Joshluk3328j/FYP/agatha/readme

this file has the ultrasonics implemented but they still dont identify obstacles when the robot is in motion and at certain angles.

the imu and odom are utilised here and fused together
