Joshluk3328j/FYP/Final Year Project_bb.png

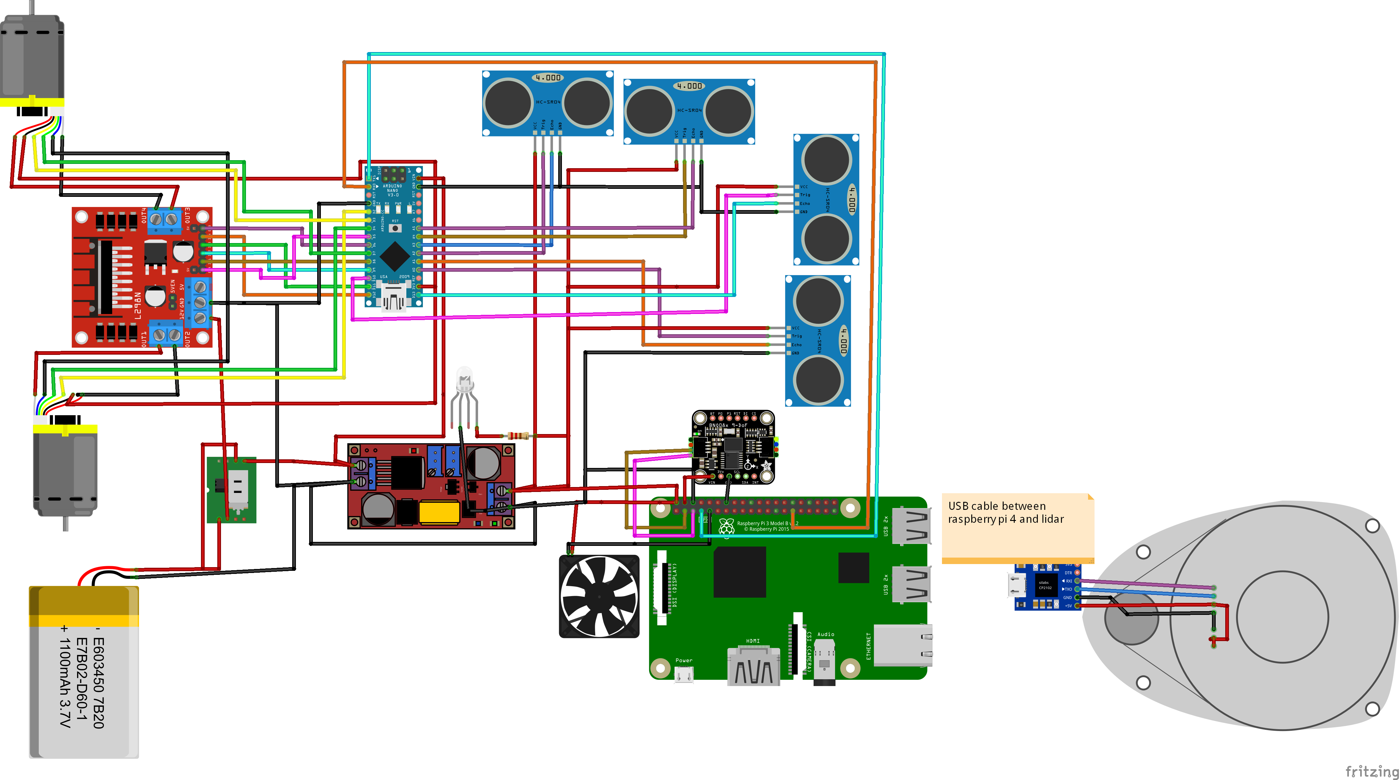
Final Year Project_bb.png
