Joshluk3328j/FYP/Final Year Project_schem.png

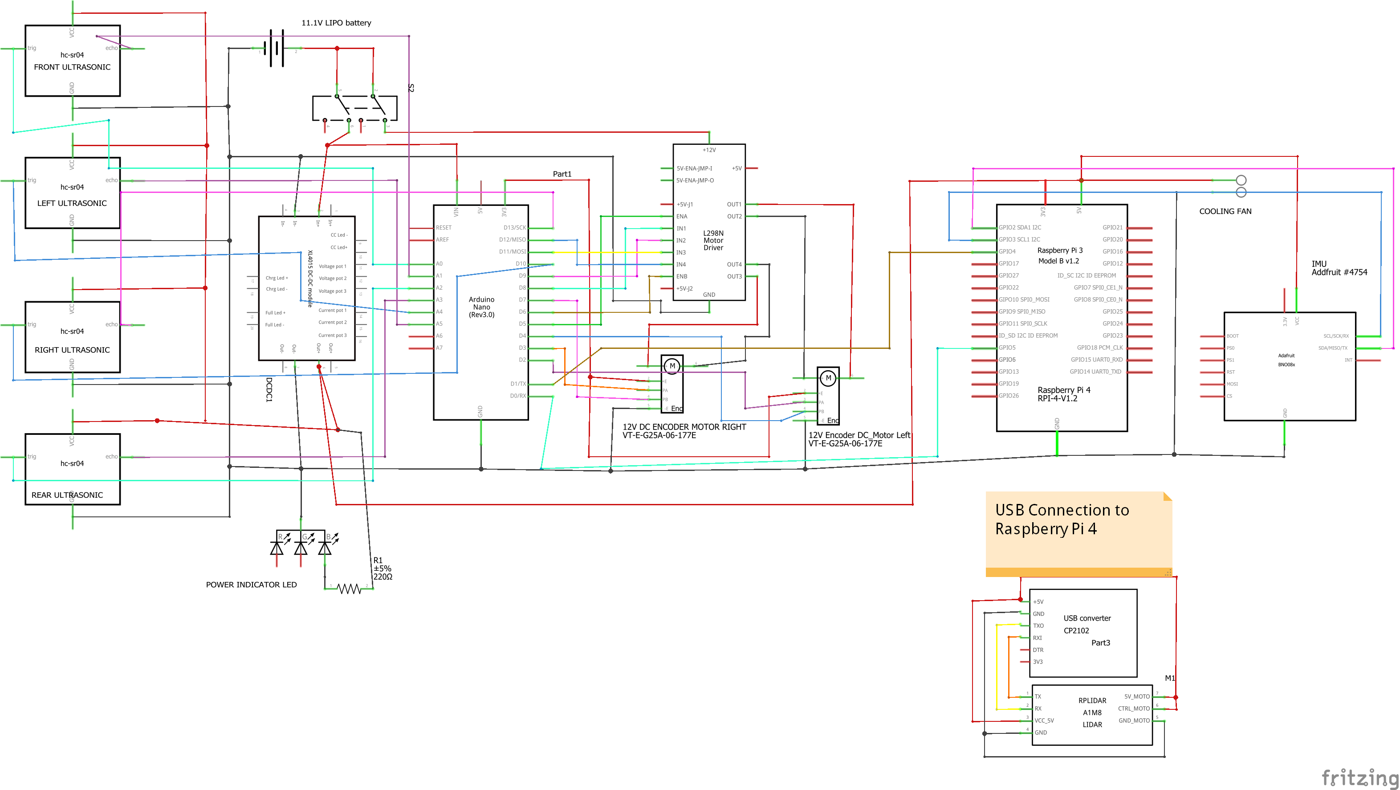
Final Year Project_schem.png
