Joshluk3328j/FYP/Screenshot from 2026-04-25 02-01-53.png

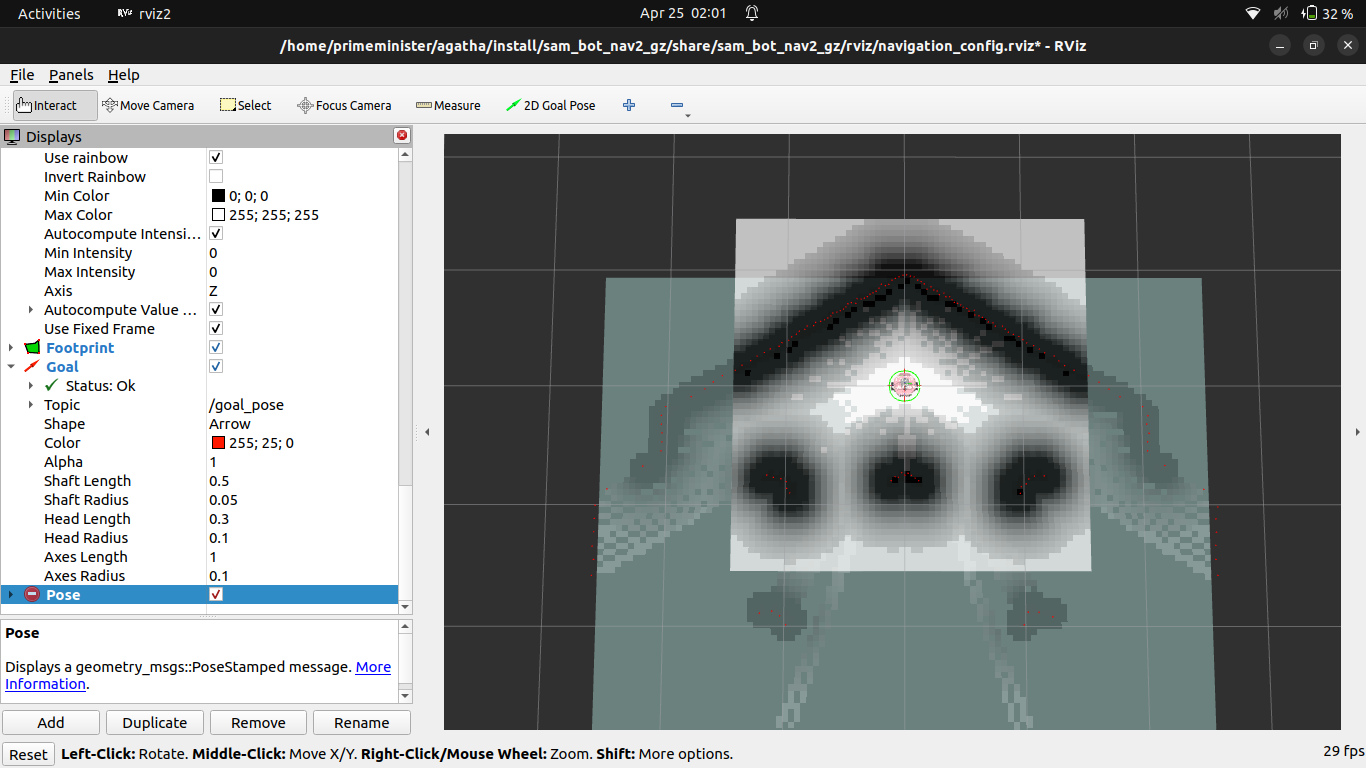
Screenshot from 2026-04-25 02-01-53.png
