Joshluk3328j/FYP/Screenshot from 2026-04-25 02-02-07.png

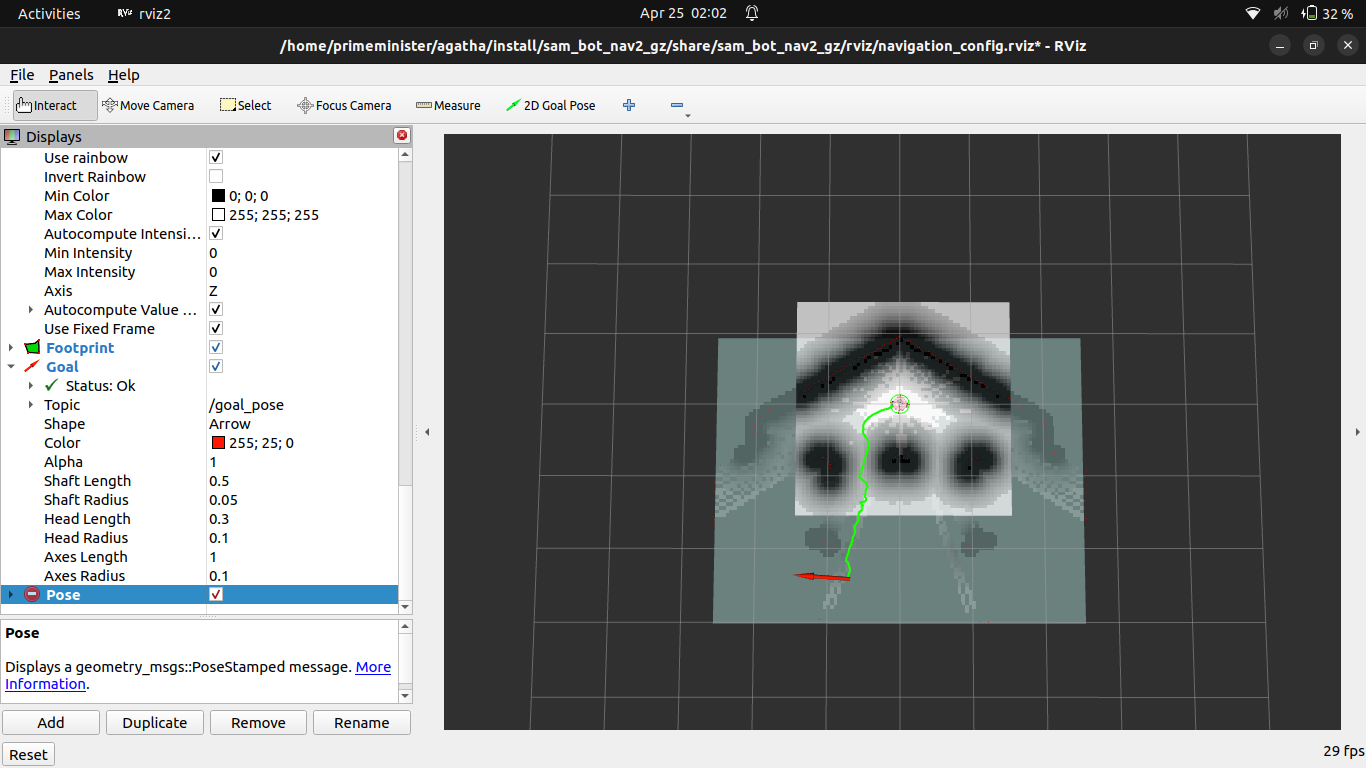
Screenshot from 2026-04-25 02-02-07.png
