Joshluk3328j/FYP/Turtle_world.png

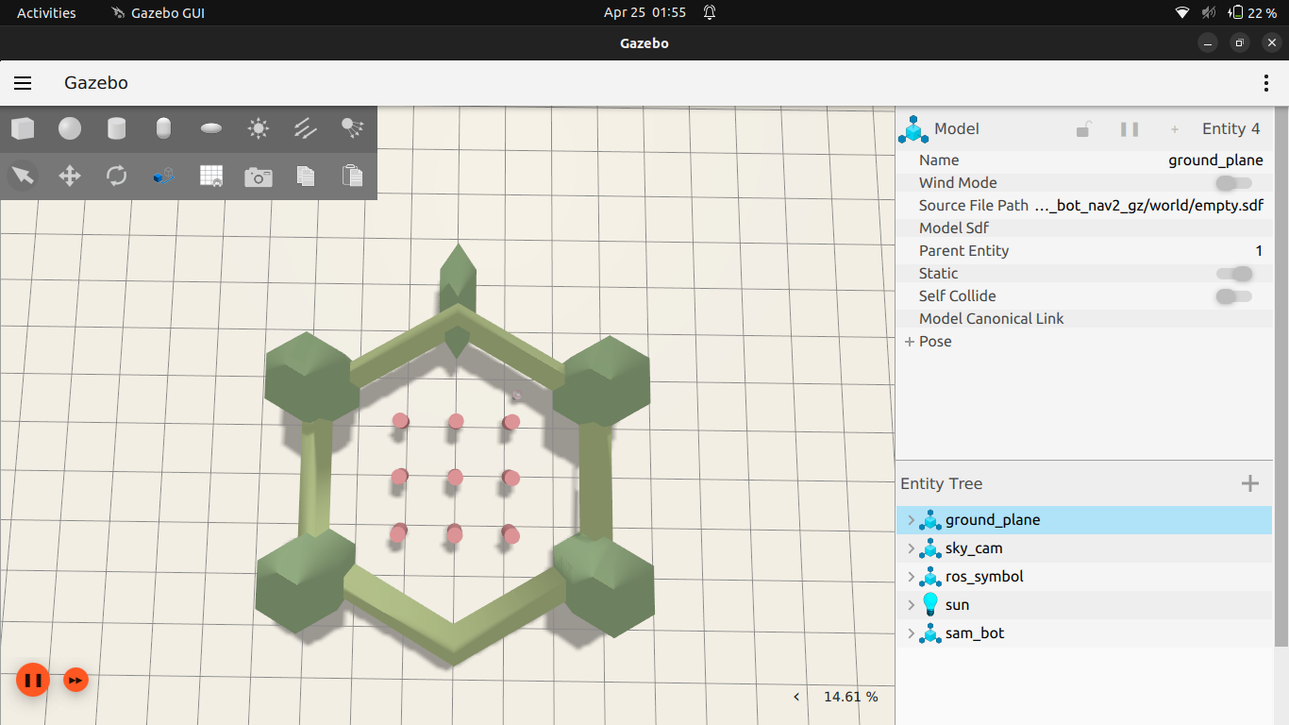
Turtle_world.png
