Joshluk3328j/FYP/AGATHA_CAD_Model/parts/Caster-swivel-40mm_assembly.step

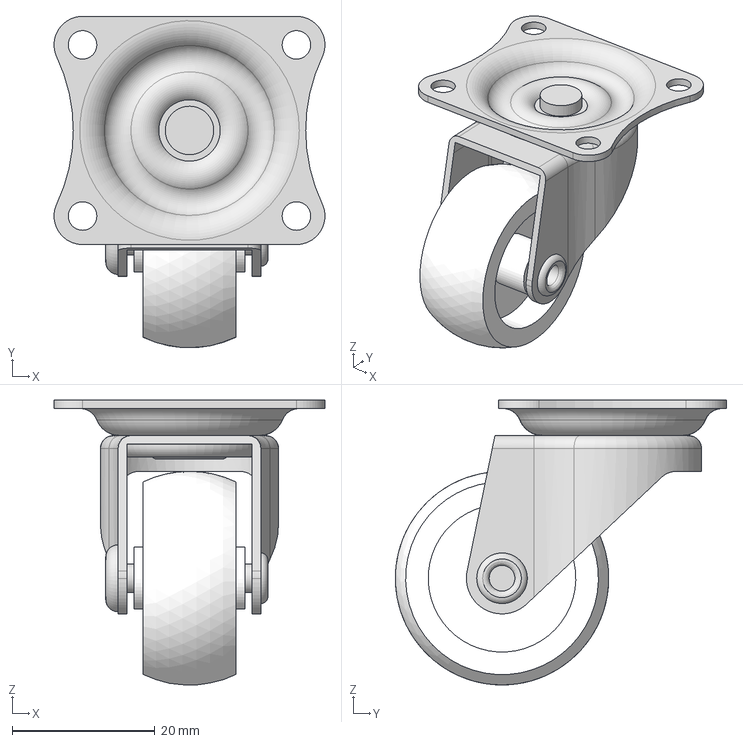
[picture p8: CAD file, 2026-02-10]
AGATHA_CAD_Model/parts/Caster-swivel-40mm_assembly.step
38.0 x 46.5 x 40.0 mm
