Joshluk3328j/FYP/agatha/install/sam_bot_nav2_gz/share/sam_bot_nav2_gz/meshes/front_ultrasonic.STL

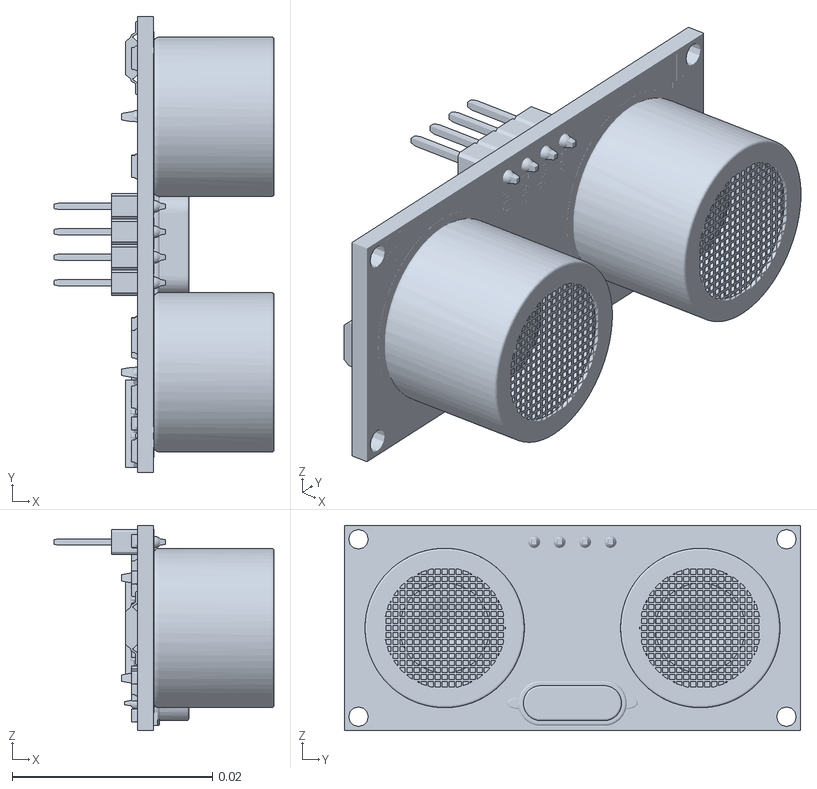
[picture p9: CAD file, 2026-10-19]
agatha/install/sam_bot_nav2_gz/share/sam_bot_nav2_gz/meshes/front_ultrasonic.STL
0.0219 x 0.0455 x 0.0205
