Joshluk3328j/FYP/AGATHA_CAD_Model/Assem2/meshes/right_wheel.STL

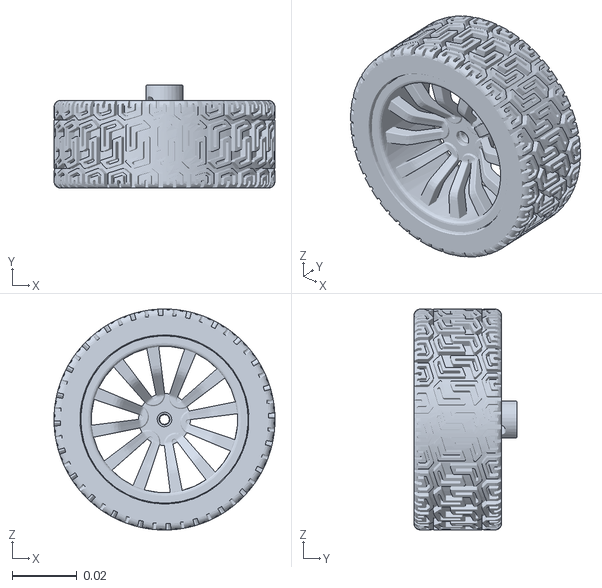
[picture p10: CAD file, 2026-02-10]
AGATHA_CAD_Model/Assem2/meshes/right_wheel.STL
0.068 x 0.0317 x 0.068
