Joshluk3328j/FYP/agatha/install/sam_bot_nav2_gz/share/sam_bot_nav2_gz/meshes/lidar.STL

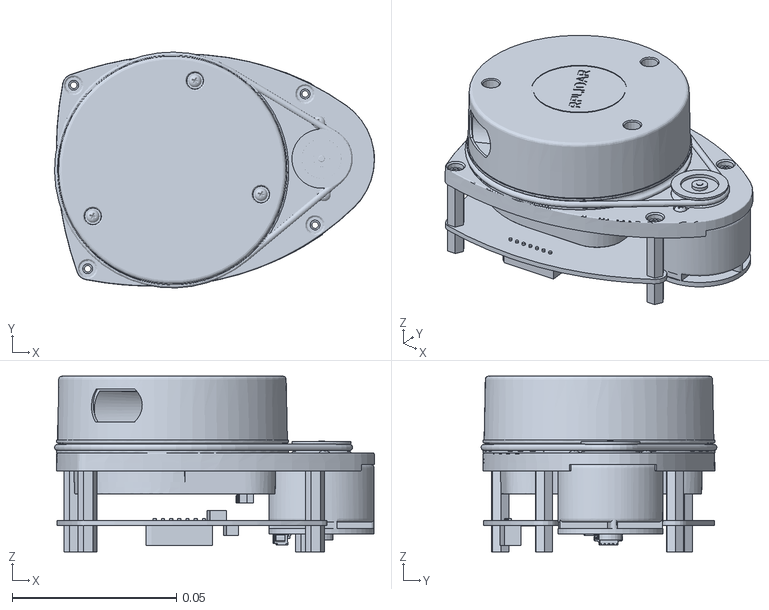
[picture p11: CAD file, 2026-10-19]
agatha/install/sam_bot_nav2_gz/share/sam_bot_nav2_gz/meshes/lidar.STL
0.0974 x 0.0718 x 0.0535
