Joshluk3328j/FYP/agatha/meshes/front_castor_wheel.STL

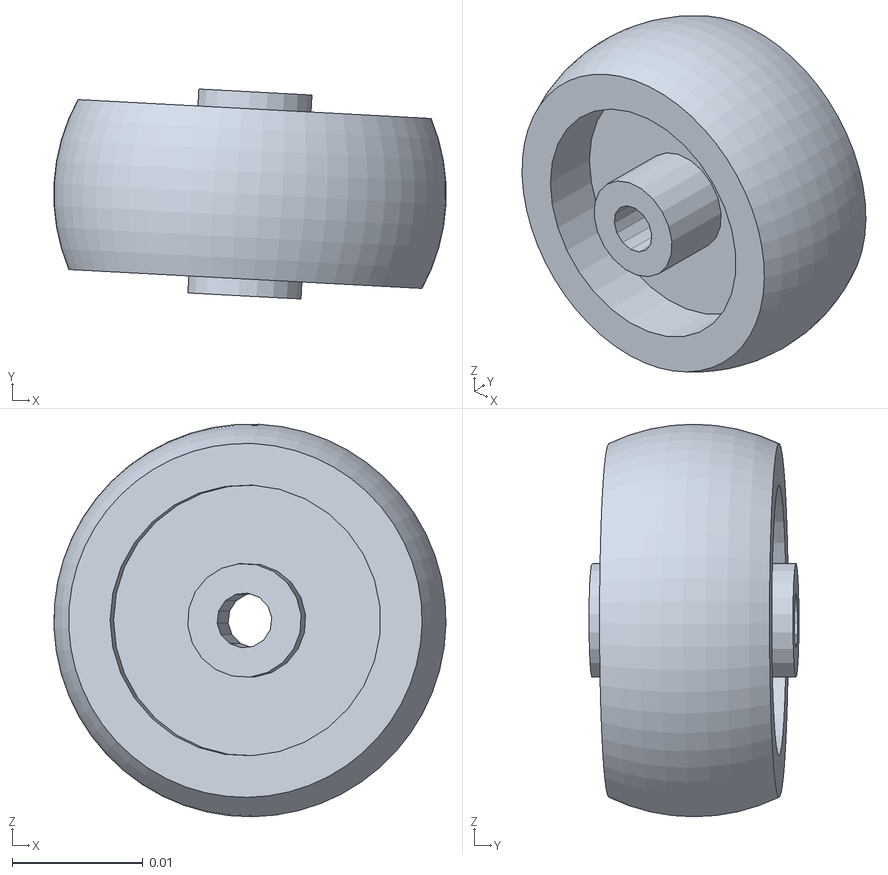
[picture p12: CAD file, 2026-02-10]
agatha/meshes/front_castor_wheel.STL
0.0299 x 0.016 x 0.03
