Joshluk3328j/FYP/AGATHA_CAD_Model/Assem2/meshes/front_castor_swivel.STL

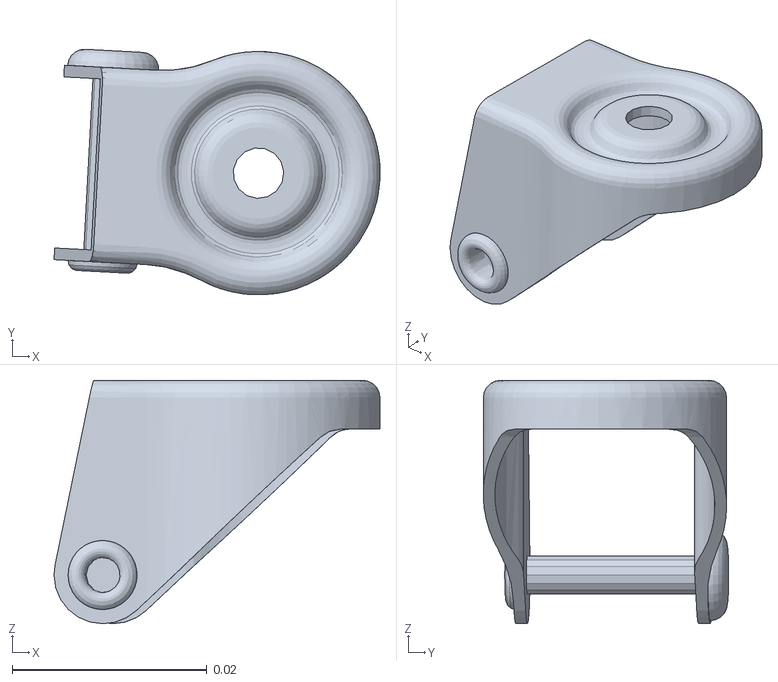
[picture p13: CAD file, 2026-02-10]
AGATHA_CAD_Model/Assem2/meshes/front_castor_swivel.STL
0.0335 x 0.0252 x 0.025
