Joshluk3328j/FYP/agatha/src/meshes/tof.STL

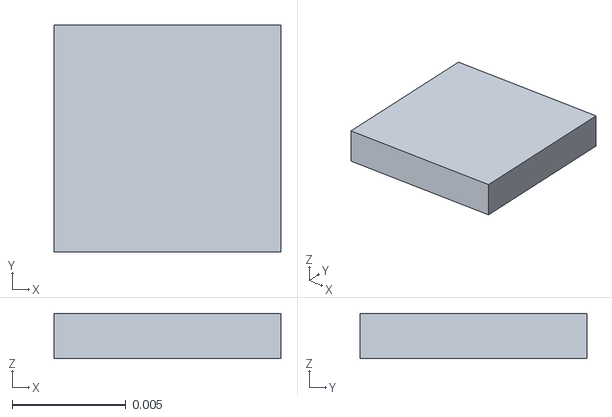
[picture p14: CAD file, 2026-02-10]
agatha/src/meshes/tof.STL
0.01 x 0.01 x 0.002
