Joshluk3328j/FYP/agatha/install/sam_bot_nav2_gz/share/sam_bot_nav2_gz/meshes/base_link.STL

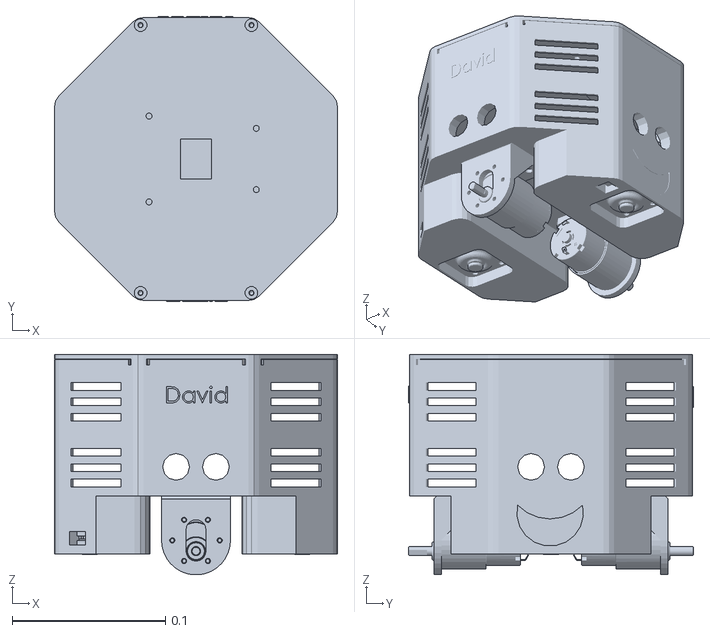
[picture p15: CAD file, 2026-02-10]
agatha/install/sam_bot_nav2_gz/share/sam_bot_nav2_gz/meshes/base_link.STL
0.185 x 0.186 x 0.144
