Joshluk3328j/FYP/agatha/src/meshes/imu.STL

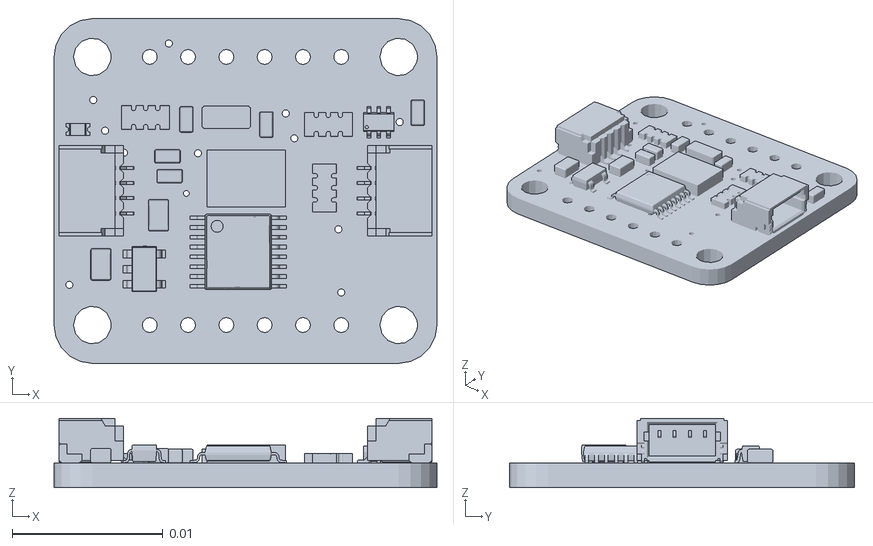
[picture p16: CAD file, 2026-02-10]
agatha/src/meshes/imu.STL
0.0254 x 0.0229 x 0.0046
