Joshluk3328j/FYP/agatha/src/meshes/rear_castor_swivel.STL

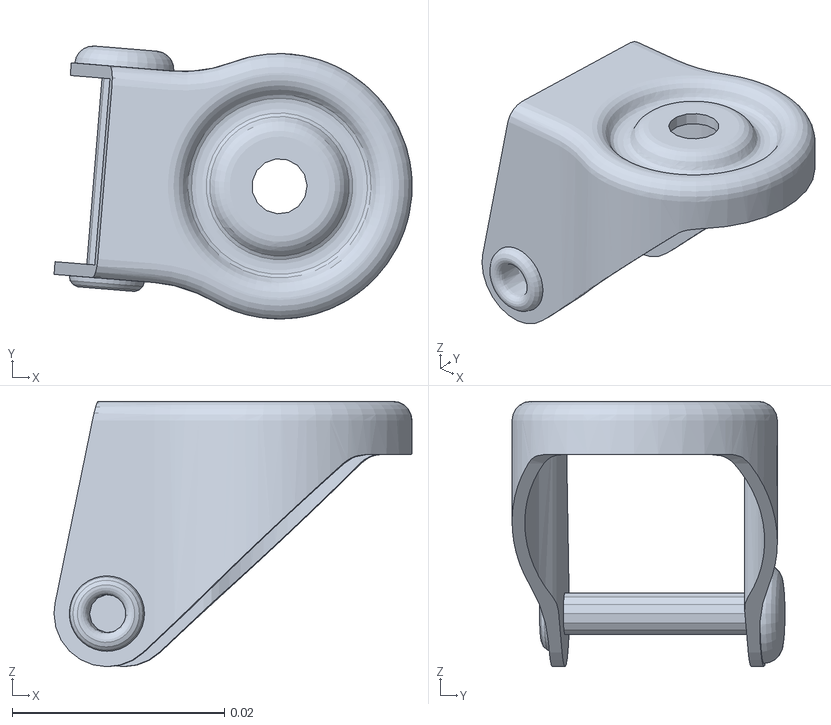
[picture p17: CAD file, 2026-02-10]
agatha/src/meshes/rear_castor_swivel.STL
0.0337 x 0.0257 x 0.025
