Joshluk3328j/FYP/AGATHA_CAD_Model/parts/Base.SLDPRT

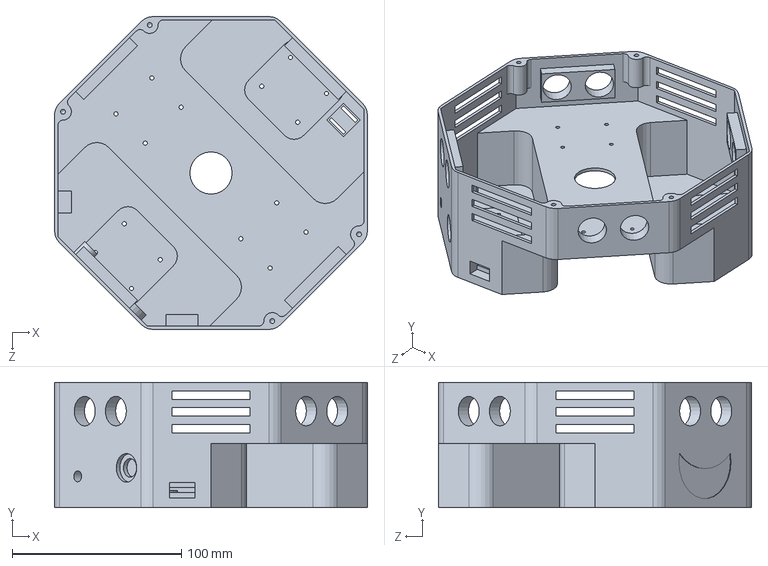
[picture p18: CAD file, 2026-04-25]
AGATHA_CAD_Model/parts/Base.SLDPRT
184.8 x 74.0 x 184.8 mm
