Joshluk3328j/FYP/AGATHA_CAD_Model/parts/Body1_caster.SLDPRT

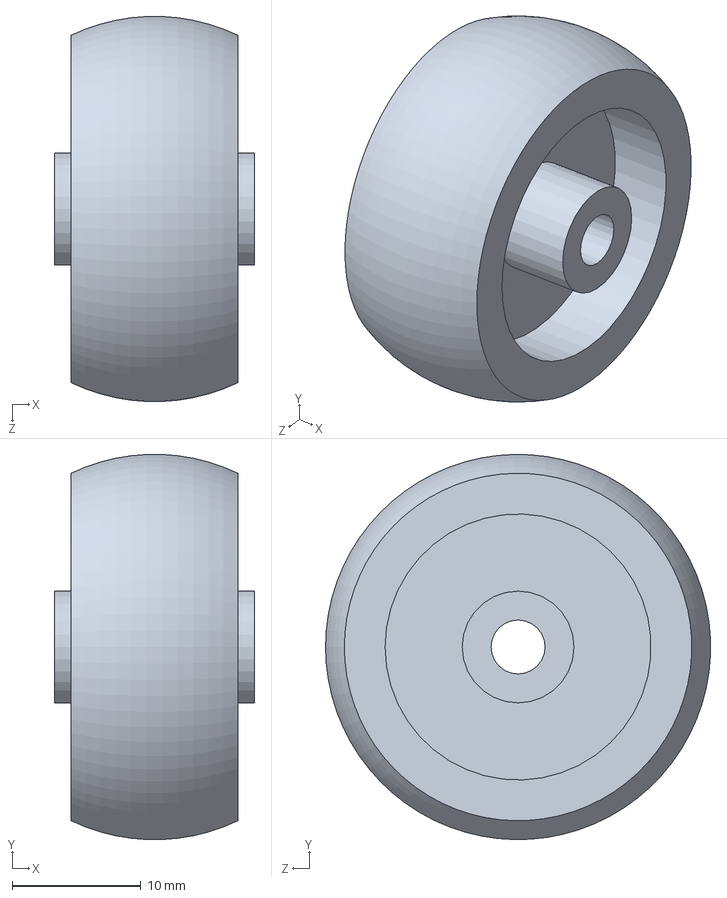
[picture p19: CAD file, 2026-02-10]
AGATHA_CAD_Model/parts/Body1_caster.SLDPRT
15.6 x 30.0 x 30.0 mm
