Joshluk3328j/FYP/AGATHA_CAD_Model/parts/Body2_caster.SLDPRT

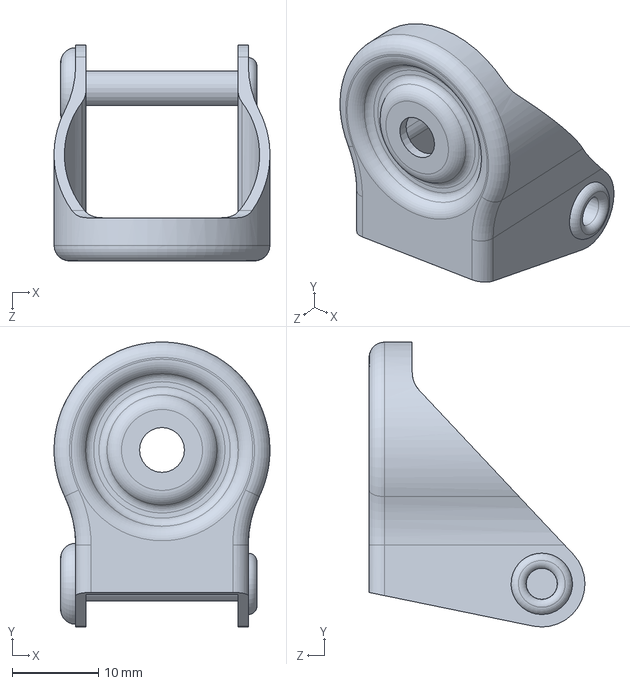
[picture p22: CAD file, 2026-02-10]
AGATHA_CAD_Model/parts/Body2_caster.SLDPRT
25.0 x 33.0 x 25.0 mm
