Joshluk3328j/FYP/AGATHA_CAD_Model/parts/vl53l0x.STEP

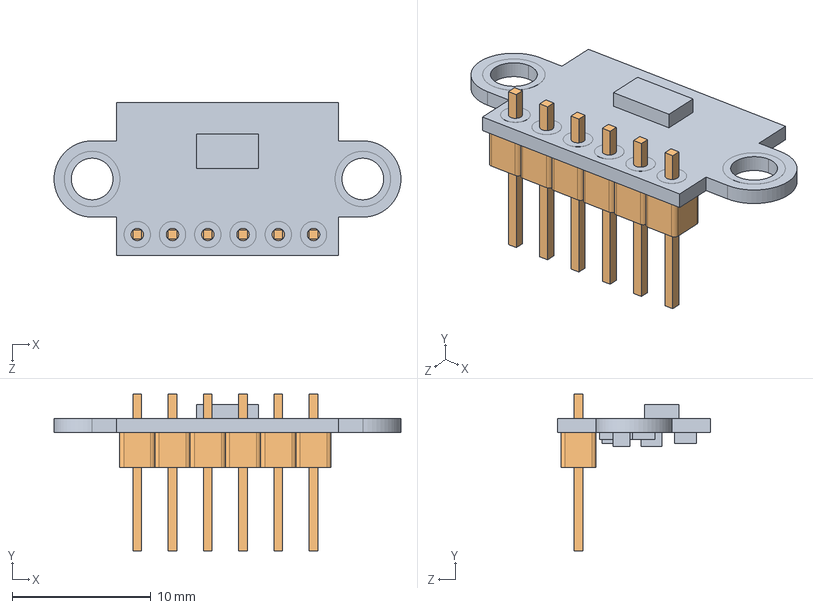
[picture p23: CAD file, 2026-02-10]
AGATHA_CAD_Model/parts/vl53l0x.STEP
25.0 x 11.3 x 11.0 mm
vl53l0x_PCB
pin_header x 6
