Joshluk3328j/FYP/AGATHA_CAD_Model/parts/Caster Ball Wheel.STEP

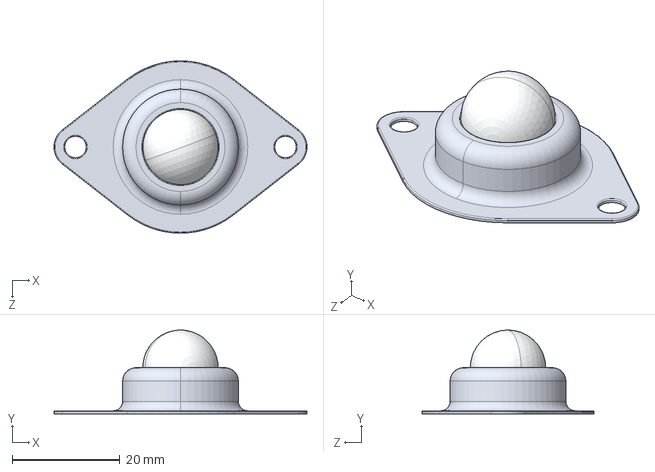
[picture p24: CAD file, 2026-02-10]
AGATHA_CAD_Model/parts/Caster Ball Wheel.STEP
47.0 x 15.6 x 32.0 mm
Wheel''s Body
Ball
