Joshluk3328j/FYP/AGATHA_CAD_Model/parts/LIDAR X4 PRO.STEP

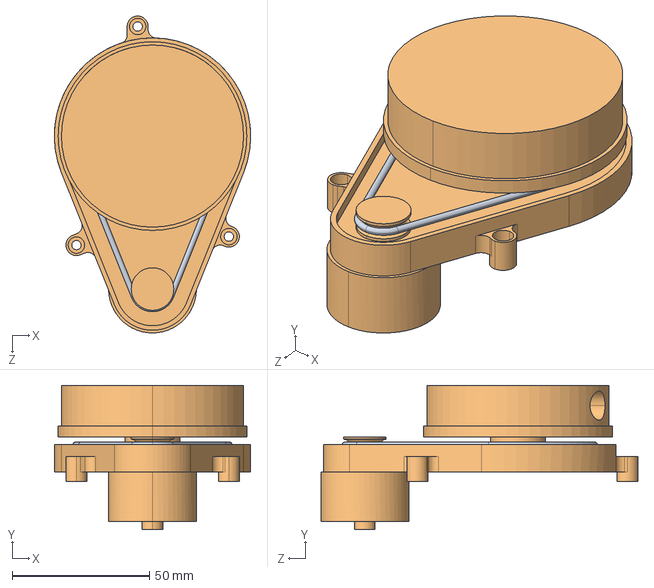
[picture p25: CAD file, 2026-02-10]
AGATHA_CAD_Model/parts/LIDAR X4 PRO.STEP
71.5 x 52.5 x 115.4 mm
