Joshluk3328j/FYP/AGATHA_CAD_Model/parts/Body3_caster.SLDPRT

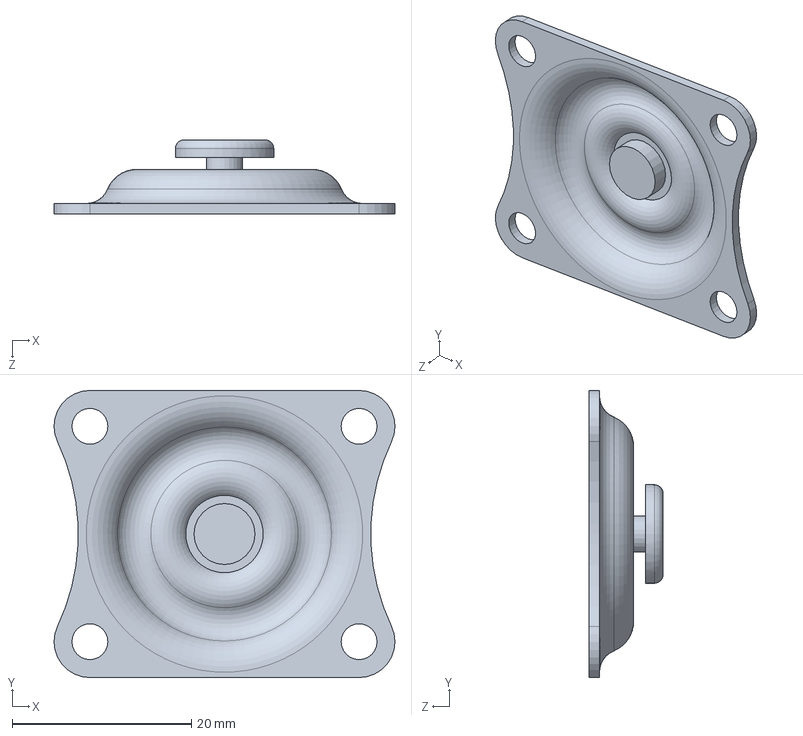
[picture p26: CAD file, 2026-02-10]
AGATHA_CAD_Model/parts/Body3_caster.SLDPRT
38.0 x 32.0 x 8.30 mm
