Joshluk3328j/FYP/AGATHA_CAD_Model/parts/GY-530 VL53L0X ToF.obj

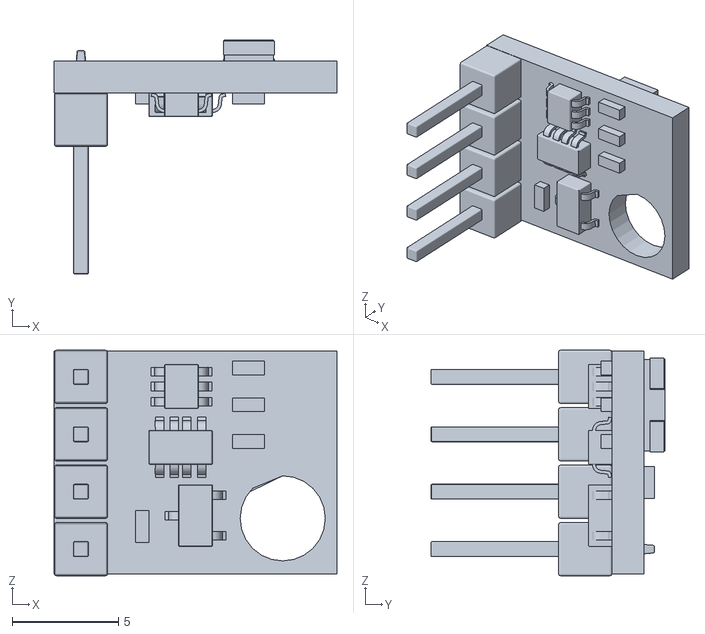
[picture p27: CAD file, 2026-02-10]
AGATHA_CAD_Model/parts/GY-530 VL53L0X ToF.obj
13.3 x 11.0 x 10.6
