Joshluk3328j/FYP/AGATHA_CAD_Model/parts/Top.SLDPRT

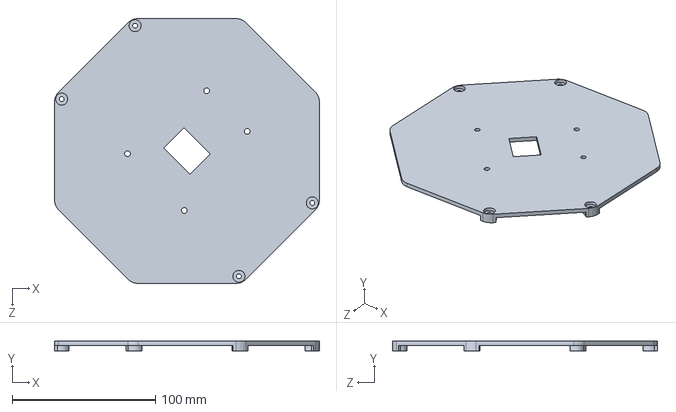
[picture p28: CAD file, 2026-02-10]
AGATHA_CAD_Model/parts/Top.SLDPRT
184.8 x 7.00 x 184.8 mm
