Joshluk3328j/FYP/AGATHA_CAD_Model/parts/DC Fan Model v5.step

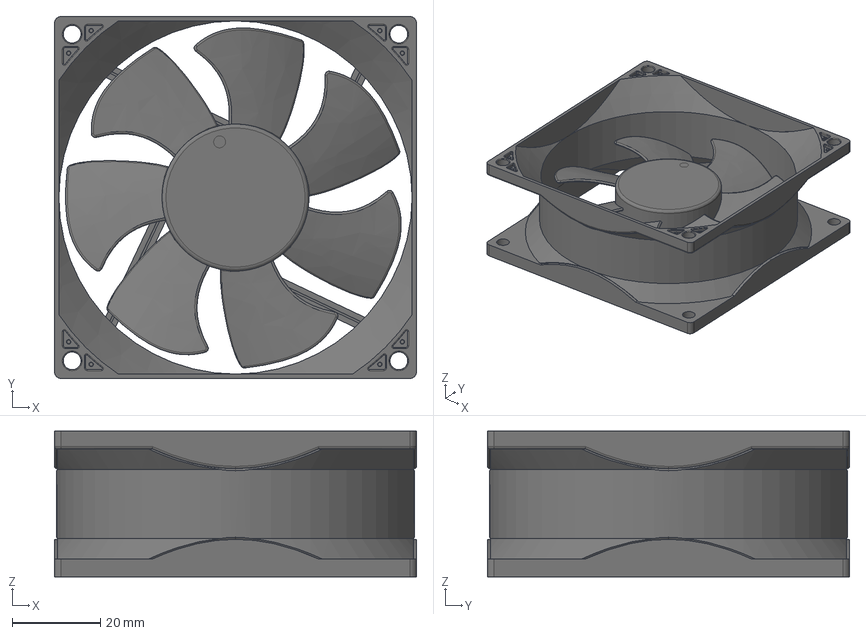
[picture p29: CAD file, 2026-02-10]
AGATHA_CAD_Model/parts/DC Fan Model v5.step
82.0 x 82.0 x 33.0 mm
Fan
Housing
Motor Simple
