Joshluk3328j/FYP/AGATHA_CAD_Model/parts/BatteryHolder3S.STEP

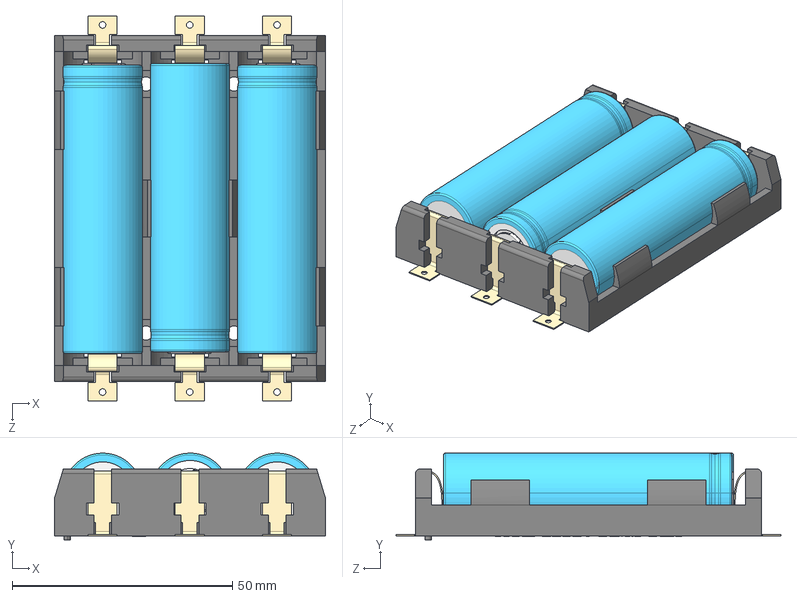
[picture p30: CAD file, 2026-02-10]
AGATHA_CAD_Model/parts/BatteryHolder3S.STEP
61.5 x 19.7 x 87.3 mm
BatteryCasePlastic
BatteryCaseSpring x 6
Battery18650 x 3
