Joshluk3328j/FYP/AGATHA_CAD_Model/parts/tof_prop.SLDPRT

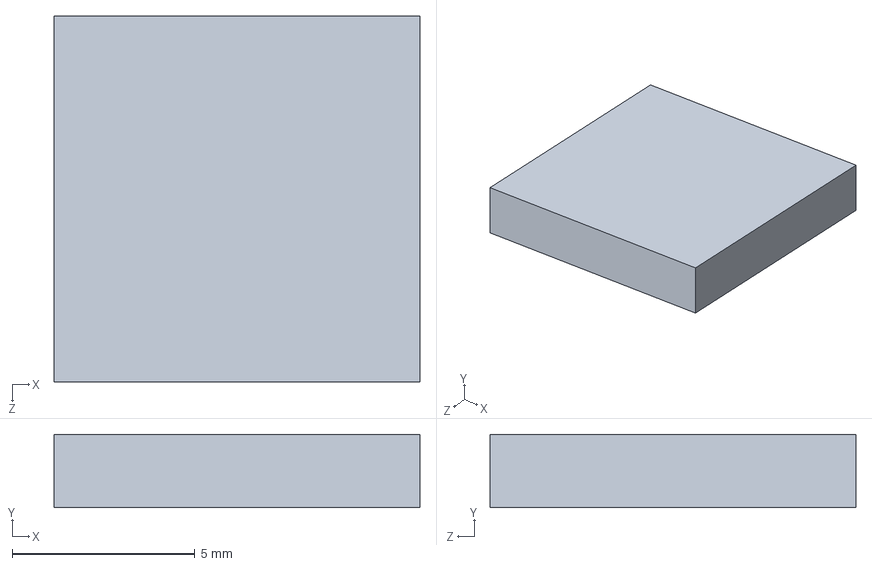
[picture p31: CAD file, 2026-02-10]
AGATHA_CAD_Model/parts/tof_prop.SLDPRT
10.0 x 2.00 x 10.0 mm
