Joshluk3328j/FYP/AGATHA_CAD_Model/parts/MM-JGB37 v4.stp

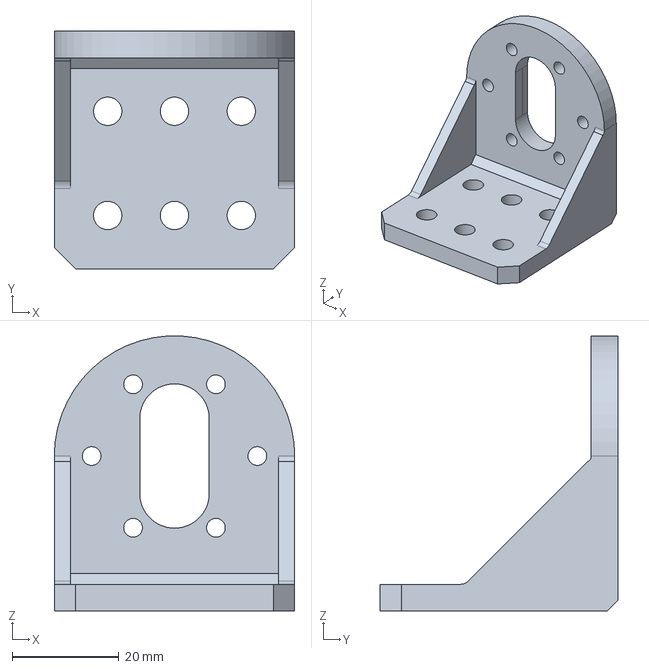
[picture p32: CAD file, 2026-02-10]
AGATHA_CAD_Model/parts/MM-JGB37 v4.stp
45.0 x 44.5 x 51.5 mm
