Joshluk3328j/FYP/AGATHA_CAD_Model/parts/Layer1.SLDPRT

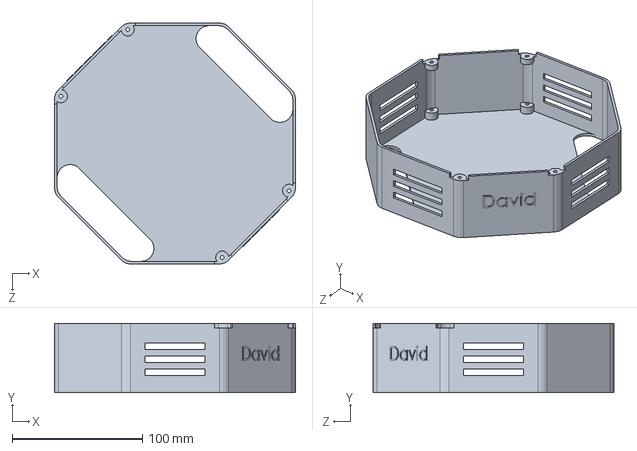
[picture p33: CAD file, 2026-02-10]
AGATHA_CAD_Model/parts/Layer1.SLDPRT
184.8 x 53.0 x 184.8 mm
