Joshluk3328j/FYP/AGATHA_CAD_Model/parts/Fan_30x30x8_5V_2pin.stp

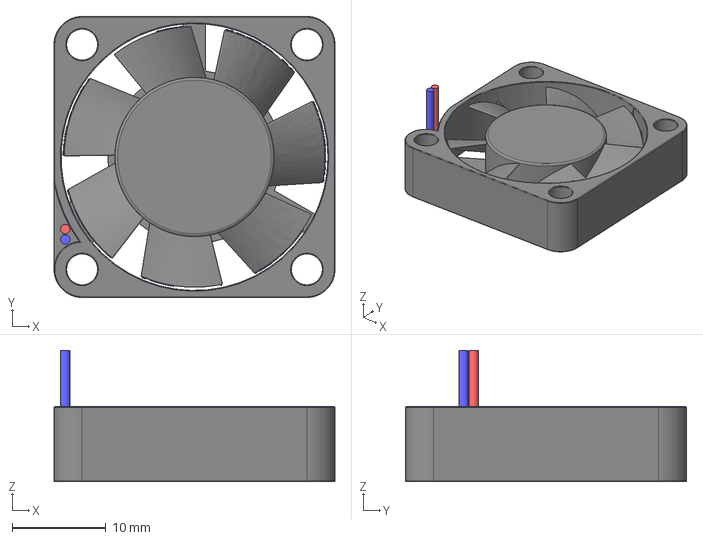
[picture p34: CAD file, 2026-02-10]
AGATHA_CAD_Model/parts/Fan_30x30x8_5V_2pin.stp
30.0 x 30.0 x 14.0 mm
Rotator
