Joshluk3328j/FYP/(list of files, cad)

Other CAD files:
agatha/meshes/rear_ultrasonic.STL
agatha/src/meshes/left_ultrasonic.STL
AGATHA_CAD_Model/parts/Assem123.STEP
agatha/src/meshes/right_ultrasonic.STL
AGATHA_CAD_Model/parts/Assem1234.STEP
agatha/install/sam_bot_nav2_gz/share/sam_bot_nav2_gz/meshes/left_wheel.STL
AGATHA_CAD_Model/Assem2/meshes/rear_castor_wheel.STL
AGATHA_CAD_Model/parts/Assem2.STEP
AGATHA_CAD_Model/parts/Assem12.STEP
AGATHA_CAD_Model/parts/Caster.SLDPRT
AGATHA_CAD_Model/Assem2 - Copy/meshes/rear_castor_wheel.STL
AGATHA_CAD_Model/parts/Assem12.SLDASM
AGATHA_CAD_Model/parts/Assem123.SLDPRT
AGATHA_CAD_Model/parts/RP-lidar-A1.iam
AGATHA_CAD_Model/stl/Base.STL
AGATHA_CAD_Model/stl/Layer1.STL
AGATHA_CAD_Model/stl/Top.STL
