Joshluk3328j/FYP/agatha/build/apf_controller/install_manifest.txt

/home/jo/agatha/install/apf_controller/share/apf_controller/plugin.xml
/home/jo/agatha/install/apf_controller/lib/libapf_controller.so
/home/jo/agatha/install/apf_controller/include/apf_controller/apf_controller.hpp
/home/jo/agatha/install/apf_controller/include/apf_controller/apf_controller copy.hpp
/home/jo/agatha/install/apf_controller/share/apf_controller/plugin.xml
/home/jo/agatha/install/apf_controller/share/ament_index/resource_index/package_run_dependencies/apf_controller
/home/jo/agatha/install/apf_controller/share/ament_index/resource_index/parent_prefix_path/apf_controller
/home/jo/agatha/install/apf_controller/share/apf_controller/environment/ament_prefix_path.sh
/home/jo/agatha/install/apf_controller/share/apf_controller/environment/ament_prefix_path.dsv
/home/jo/agatha/install/apf_controller/share/apf_controller/environment/path.sh
/home/jo/agatha/install/apf_controller/share/apf_controller/environment/path.dsv
/home/jo/agatha/install/apf_controller/share/apf_controller/local_setup.bash
/home/jo/agatha/install/apf_controller/share/apf_controller/local_setup.sh
/home/jo/agatha/install/apf_controller/share/apf_controller/local_setup.zsh
/home/jo/agatha/install/apf_controller/share/apf_controller/local_setup.dsv
/home/jo/agatha/install/apf_controller/share/apf_controller/package.dsv
/home/jo/agatha/install/apf_controller/share/ament_index/resource_index/packages/apf_controller
/home/jo/agatha/install/apf_controller/share/ament_index/resource_index/nav2_core__pluginlib__plugin/apf_controller
/home/jo/agatha/install/apf_controller/share/apf_controller/cmake/apf_controllerConfig.cmake
/home/jo/agatha/install/apf_controller/share/apf_controller/cmake/apf_controllerConfig-version.cmake
/home/jo/agatha/install/apf_controller/share/apf_controller/package.xml
