Joshluk3328j/FYP/agatha/build/dstar_lite_planner/install_manifest.txt

/home/jo/agatha/install/dstar_lite_planner/share/dstar_lite_planner/plugin.xml
/home/jo/agatha/install/dstar_lite_planner/lib/libdstar_lite_planner.so
/home/jo/agatha/install/dstar_lite_planner/include/dstar_lite_planner/dstar_lite.hpp
/home/jo/agatha/install/dstar_lite_planner/include/dstar_lite_planner/dstar_lite_planner.hpp
/home/jo/agatha/install/dstar_lite_planner/share/dstar_lite_planner/plugin.xml
/home/jo/agatha/install/dstar_lite_planner/share/ament_index/resource_index/package_run_dependencies/dstar_lite_planner
/home/jo/agatha/install/dstar_lite_planner/share/ament_index/resource_index/parent_prefix_path/dstar_lite_planner
/home/jo/agatha/install/dstar_lite_planner/share/dstar_lite_planner/environment/ament_prefix_path.sh
/home/jo/agatha/install/dstar_lite_planner/share/dstar_lite_planner/environment/ament_prefix_path.dsv
/home/jo/agatha/install/dstar_lite_planner/share/dstar_lite_planner/environment/path.sh
/home/jo/agatha/install/dstar_lite_planner/share/dstar_lite_planner/environment/path.dsv
/home/jo/agatha/install/dstar_lite_planner/share/dstar_lite_planner/local_setup.bash
/home/jo/agatha/install/dstar_lite_planner/share/dstar_lite_planner/local_setup.sh
/home/jo/agatha/install/dstar_lite_planner/share/dstar_lite_planner/local_setup.zsh
/home/jo/agatha/install/dstar_lite_planner/share/dstar_lite_planner/local_setup.dsv
/home/jo/agatha/install/dstar_lite_planner/share/dstar_lite_planner/package.dsv
/home/jo/agatha/install/dstar_lite_planner/share/ament_index/resource_index/packages/dstar_lite_planner
/home/jo/agatha/install/dstar_lite_planner/share/ament_index/resource_index/nav2_core__pluginlib__plugin/dstar_lite_planner
/home/jo/agatha/install/dstar_lite_planner/share/dstar_lite_planner/cmake/dstar_lite_plannerConfig.cmake
/home/jo/agatha/install/dstar_lite_planner/share/dstar_lite_planner/cmake/dstar_lite_plannerConfig-version.cmake
/home/jo/agatha/install/dstar_lite_planner/share/dstar_lite_planner/package.xml
