Joshluk3328j/FYP/agatha/build/sam_bot_nav2_gz/install_manifest.txt

/home/jo/agatha/install/sam_bot_nav2_gz/share/sam_bot_nav2_gz/src/description/sam_bot_description copy.urdf
/home/jo/agatha/install/sam_bot_nav2_gz/share/sam_bot_nav2_gz/src/description/sam_bot_description.urdf
/home/jo/agatha/install/sam_bot_nav2_gz/share/sam_bot_nav2_gz/scripts/__init__.py
/home/jo/agatha/install/sam_bot_nav2_gz/share/sam_bot_nav2_gz/scripts/follow_waypoints.py
/home/jo/agatha/install/sam_bot_nav2_gz/share/sam_bot_nav2_gz/scripts/reach_goal.py
/home/jo/agatha/install/sam_bot_nav2_gz/share/sam_bot_nav2_gz/launch/complete_navigation.launch copy.py
/home/jo/agatha/install/sam_bot_nav2_gz/share/sam_bot_nav2_gz/launch/hardware_bringup.launch copy.py
/home/jo/agatha/install/sam_bot_nav2_gz/share/sam_bot_nav2_gz/launch/complete_navigation.launch.py
/home/jo/agatha/install/sam_bot_nav2_gz/share/sam_bot_nav2_gz/launch/hardware_bringup.launch.py
/home/jo/agatha/install/sam_bot_nav2_gz/share/sam_bot_nav2_gz/launch/display.launch.py
/home/jo/agatha/install/sam_bot_nav2_gz/share/sam_bot_nav2_gz/rviz/navigation_config.rviz
/home/jo/agatha/install/sam_bot_nav2_gz/share/sam_bot_nav2_gz/rviz/urdf_config.rviz
/home/jo/agatha/install/sam_bot_nav2_gz/share/sam_bot_nav2_gz/config/ekf copy.yaml
/home/jo/agatha/install/sam_bot_nav2_gz/share/sam_bot_nav2_gz/config/nav2_params copy 2.yaml
/home/jo/agatha/install/sam_bot_nav2_gz/share/sam_bot_nav2_gz/config/diff_drive_controller_velocity.yaml
/home/jo/agatha/install/sam_bot_nav2_gz/share/sam_bot_nav2_gz/config/ekf.yaml
/home/jo/agatha/install/sam_bot_nav2_gz/share/sam_bot_nav2_gz/config/nav2_params.yaml
/home/jo/agatha/install/sam_bot_nav2_gz/share/sam_bot_nav2_gz/config/planners/dstar_apf.yaml
/home/jo/agatha/install/sam_bot_nav2_gz/share/sam_bot_nav2_gz/config/planners/navfn_apf.yaml
/home/jo/agatha/install/sam_bot_nav2_gz/share/sam_bot_nav2_gz/config/planners/dstar_dwa.yaml
/home/jo/agatha/install/sam_bot_nav2_gz/share/sam_bot_nav2_gz/config/planners/dstar_rpp.yaml
/home/jo/agatha/install/sam_bot_nav2_gz/share/sam_bot_nav2_gz/config/planners/navfn_dwa.yaml
/home/jo/agatha/install/sam_bot_nav2_gz/share/sam_bot_nav2_gz/config/planners/navfn_rpp.yaml
/home/jo/agatha/install/sam_bot_nav2_gz/share/sam_bot_nav2_gz/config/nav2_params copy.yaml
/home/jo/agatha/install/sam_bot_nav2_gz/share/sam_bot_nav2_gz/world/bookstore.sdf
/home/jo/agatha/install/sam_bot_nav2_gz/share/sam_bot_nav2_gz/world/empty.sdf
/home/jo/agatha/install/sam_bot_nav2_gz/share/sam_bot_nav2_gz/models/aws_robomaker_retail_ColumnB_01/materials/textures/aws_ColumnB_01.png
/home/jo/agatha/install/sam_bot_nav2_gz/share/sam_bot_nav2_gz/models/aws_robomaker_retail_ColumnB_01/model.sdf
/home/jo/agatha/install/sam_bot_nav2_gz/share/sam_bot_nav2_gz/models/aws_robomaker_retail_ColumnB_01/meshes/aws_ColumnB_01_visual.DAE
/home/jo/agatha/install/sam_bot_nav2_gz/share/sam_bot_nav2_gz/models/aws_robomaker_retail_ColumnB_01/meshes/aws_ColumnB_01_collision.DAE
/home/jo/agatha/install/sam_bot_nav2_gz/share/sam_bot_nav2_gz/models/aws_robomaker_retail_ColumnB_01/model.config
/home/jo/agatha/install/sam_bot_nav2_gz/share/sam_bot_nav2_gz/models/aws_robomaker_retail_SecurityCamera_01/materials/textures/aws_SecurityCamera_01.png
/home/jo/agatha/install/sam_bot_nav2_gz/share/sam_bot_nav2_gz/models/aws_robomaker_retail_SecurityCamera_01/model.sdf
/home/jo/agatha/install/sam_bot_nav2_gz/share/sam_bot_nav2_gz/models/aws_robomaker_retail_SecurityCamera_01/meshes/aws_SecurityCamera_01_visual.DAE
/home/jo/agatha/install/sam_bot_nav2_gz/share/sam_bot_nav2_gz/models/aws_robomaker_retail_SecurityCamera_01/meshes/aws_SecurityCamera_01_collision.DAE
/home/jo/agatha/install/sam_bot_nav2_gz/share/sam_bot_nav2_gz/models/aws_robomaker_retail_SecurityCamera_01/model.config
/home/jo/agatha/install/sam_bot_nav2_gz/share/sam_bot_nav2_gz/models/aws_robomaker_retail_InfoDesk_01/materials/textures/aws_InfoDesk_01.png
/home/jo/agatha/install/sam_bot_nav2_gz/share/sam_bot_nav2_gz/models/aws_robomaker_retail_InfoDesk_01/model.sdf
/home/jo/agatha/install/sam_bot_nav2_gz/share/sam_bot_nav2_gz/models/aws_robomaker_retail_InfoDesk_01/meshes/aws_InfoDesk_01_collision.DAE
/home/jo/agatha/install/sam_bot_nav2_gz/share/sam_bot_nav2_gz/models/aws_robomaker_retail_InfoDesk_01/meshes/aws_InfoDesk_01_visual.DAE
/home/jo/agatha/install/sam_bot_nav2_gz/share/sam_bot_nav2_gz/models/aws_robomaker_retail_InfoDesk_01/model.config
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
/home/jo/agatha/install/sam_bot_nav2_gz/share/sam_bot_nav2_gz//meshes/right_wheel.STL
/home/jo/agatha/install/sam_bot_nav2_gz/share/sam_bot_nav2_gz//meshes/right_ultrasonic.STL
/home/jo/agatha/install/sam_bot_nav2_gz/share/sam_bot_nav2_gz//meshes/rear_castor_swivel.STL
/home/jo/agatha/install/sam_bot_nav2_gz/share/sam_bot_nav2_gz//meshes/rear_ultrasonic.STL
/home/jo/agatha/install/sam_bot_nav2_gz/share/sam_bot_nav2_gz//meshes/front_castor_wheel.STL
/home/jo/agatha/install/sam_bot_nav2_gz/share/sam_bot_nav2_gz//meshes/tof.STL
/home/jo/agatha/install/sam_bot_nav2_gz/share/sam_bot_nav2_gz//meshes/rear_castor_wheel.STL
/home/jo/agatha/install/sam_bot_nav2_gz/share/sam_bot_nav2_gz//meshes/imu.STL
/home/jo/agatha/install/sam_bot_nav2_gz/share/sam_bot_nav2_gz//meshes/base_link.STL
/home/jo/agatha/install/sam_bot_nav2_gz/share/sam_bot_nav2_gz//meshes/left_ultrasonic.STL
/home/jo/agatha/install/sam_bot_nav2_gz/share/sam_bot_nav2_gz//meshes/front_ultrasonic.STL
/home/jo/agatha/install/sam_bot_nav2_gz/share/sam_bot_nav2_gz//meshes/left_wheel.STL
/home/jo/agatha/install/sam_bot_nav2_gz/lib/sam_bot_nav2_gz/reach_goal.py
/home/jo/agatha/install/sam_bot_nav2_gz/lib/sam_bot_nav2_gz/follow_waypoints.py
/home/jo/agatha/install/sam_bot_nav2_gz/share/ament_index/resource_index/package_run_dependencies/sam_bot_nav2_gz
/home/jo/agatha/install/sam_bot_nav2_gz/share/ament_index/resource_index/parent_prefix_path/sam_bot_nav2_gz
/home/jo/agatha/install/sam_bot_nav2_gz/share/sam_bot_nav2_gz/environment/ament_prefix_path.sh
/home/jo/agatha/install/sam_bot_nav2_gz/share/sam_bot_nav2_gz/environment/ament_prefix_path.dsv
/home/jo/agatha/install/sam_bot_nav2_gz/share/sam_bot_nav2_gz/environment/path.sh
/home/jo/agatha/install/sam_bot_nav2_gz/share/sam_bot_nav2_gz/environment/path.dsv
/home/jo/agatha/install/sam_bot_nav2_gz/share/sam_bot_nav2_gz/local_setup.bash
/home/jo/agatha/install/sam_bot_nav2_gz/share/sam_bot_nav2_gz/local_setup.sh
/home/jo/agatha/install/sam_bot_nav2_gz/share/sam_bot_nav2_gz/local_setup.zsh
/home/jo/agatha/install/sam_bot_nav2_gz/share/sam_bot_nav2_gz/local_setup.dsv
/home/jo/agatha/install/sam_bot_nav2_gz/share/sam_bot_nav2_gz/package.dsv
/home/jo/agatha/install/sam_bot_nav2_gz/share/ament_index/resource_index/packages/sam_bot_nav2_gz
/home/jo/agatha/install/sam_bot_nav2_gz/share/sam_bot_nav2_gz/cmake/sam_bot_nav2_gzConfig.cmake
/home/jo/agatha/install/sam_bot_nav2_gz/share/sam_bot_nav2_gz/cmake/sam_bot_nav2_gzConfig-version.cmake
/home/jo/agatha/install/sam_bot_nav2_gz/share/sam_bot_nav2_gz/package.xml
