Joshluk3328j/FYP/benchmark_results/Dynamic data/figures/fig5_relative_performance_heatmap.pdf

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

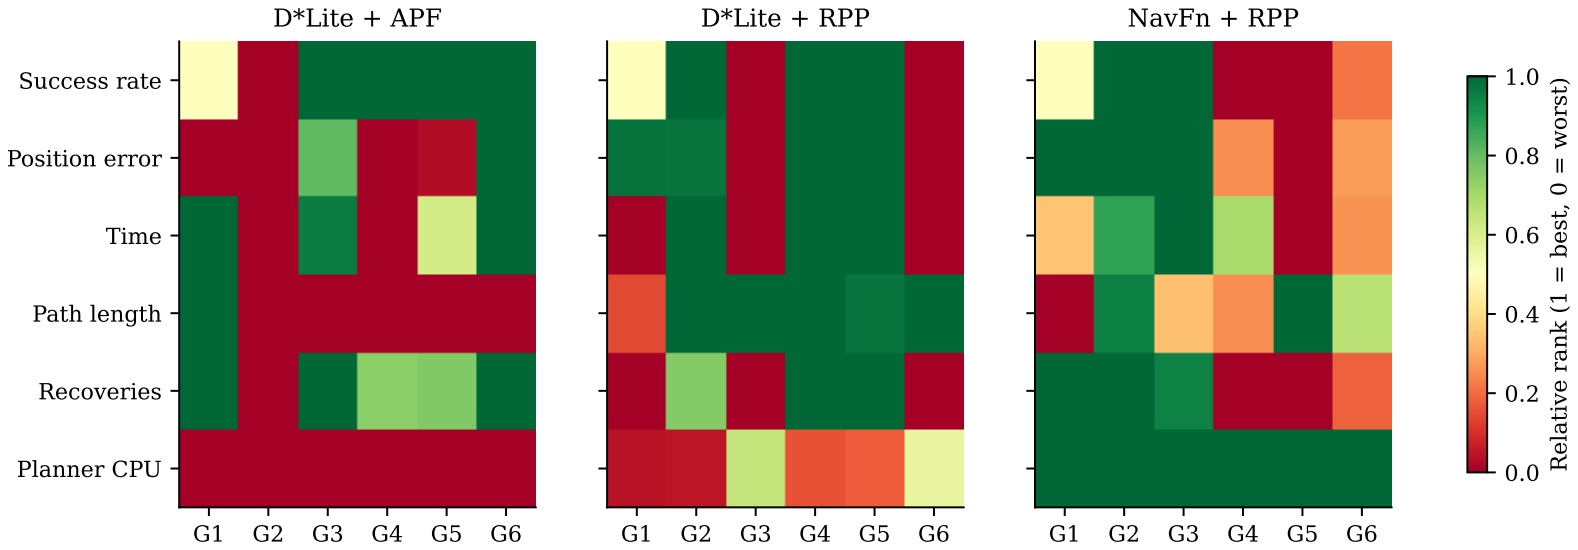
[picture p35: page 1]
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
