Joshluk3328j/FYP/benchmark_results/Dynamic data/average_dynamuc_benchmark_results/nav_benchmark_dstar_apf.csv

target_num | given_x | given_y | given_oz | given_ow | final_x | final_y | position_error_m | initial_plan_time_s | total_time_s | planned_path_length_m | actual_path_length_m | recovery_events | recovery_success | replanning_events | replanning_frequency_hz | mean_replan_interval_s | worst_replan_interval_s | planner_cpu_avg_% | planner_cpu_peak_% | controller_cpu_avg_% | controller_cpu_peak_% | planner_ram_avg_mb | planner_ram_peak_mb | controller_ram_avg_mb | controller_ram_peak_mb | nodes_expanded | success_rate | interruption_rate
1 | 1 | -0.12 | -0.71 | 0.71 | 0.82 | -0.07 | 0.19 | 0.11 | 9.67 | 0.2 | 0.88 | 0 |  | 7.5 | 0.78 | 1.08 | 1.15 | 13.54 | 16.63 | 10.9 | 41.32 | 22.73 | 22.76 | 23.23 | 23.4 |  | 1 | 1
2 | 1.25 | -1.04 | -0.71 | 0.71 | 1.13 | -0.84 | 0.24 | 0.15 | 13.69 | 0.31 | 1.04 | 1.6 |  | 8.2 | 0.78 | 1.13 | 1.36 | 14.58 | 19.07 | 13.6 | 65.71 | 22.92 | 23.04 | 23.46 | 23.51 |  | 0.95 | 1
3 | 1.41 | -2.61 | 0 | 1 | 1.47 | -2.43 | 0.21 | 0.29 | 24.71 | 0.23 | 1.92 | 1.25 |  | 16.05 | 0.74 | 1.19 | 1.67 | 18.19 | 33.45 | 12.7 | 115.78 | 23.39 | 23.48 | 23.51 | 23.56 |  | 0.95 | 1
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
