Joshluk3328j/FYP/benchmark_results/Dynamic data/average_dynamuc_benchmark_results/nav_benchmark_dstar_rpp.csv

target_num | given_x | given_y | given_oz | given_ow | final_x | final_y | position_error_m | initial_plan_time_s | total_time_s | planned_path_length_m | actual_path_length_m | recovery_events | replanning_events | replanning_frequency_hz | mean_replan_interval_s | worst_replan_interval_s | planner_cpu_avg_% | planner_cpu_peak_% | controller_cpu_avg_% | controller_cpu_peak_% | planner_ram_avg_mb | planner_ram_peak_mb | controller_ram_avg_mb | controller_ram_peak_mb | nodes_expanded | success_rate | interruption_rate
1 | 1 | -0.12 | -0.71 | 0.71 | 0.91 | -0.16 | 0.1 | 0.12 | 16.79 | 0.12 | 1.08 | 0.05 | 9.3 | 0.57 | 1.28 | 2.51 | 13.43 | 16.4 | 3.5 | 25.07 | 22.84 | 22.97 | 23.23 | 23.44 |  | 1 | 1
2 | 1.25 | -1.04 | -0.71 | 0.71 | 1.17 | -0.97 | 0.1 | 0.15 | 10.5 | 0.12 | 0.94 | 0.4 | 7.4 | 0.71 | 1.13 | 1.38 | 14.4 | 16.75 | 16.16 | 64.64 | 23.16 | 23.19 | 23.52 | 23.57 |  | 1 | 1
3 | 1.41 | -2.61 | 0 | 1 | 1.36 | -2.1 | 0.52 | 0.28 | 59.15 | 0.67 | 1.34 | 14.05 | 8.55 | 0.27 | 1.83 | 5.32 | 13.47 | 28.42 | 11.45 | 193.22 | 23.37 | 23.53 | 23.77 | 23.97 |  | 0.4 | 1
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
