Joshluk3328j/FYP/benchmark_results/Dynamic data/dynamic_benchmark_results/nav_benchmark_dstar_apf_20260905_233838.csv

trial_num | target_num | given_x | given_y | given_oz | given_ow | final_x | final_y | position_error_m | initial_plan_time_s | total_time_s | planned_path_length_m | actual_path_length_m | status | navigation_interrupted | recovery_events | recovery_success | replanning_events | replanning_frequency_hz | mean_replan_interval_s | worst_replan_interval_s | planner_cpu_avg_% | planner_cpu_peak_% | controller_cpu_avg_% | controller_cpu_peak_% | planner_ram_avg_mb | planner_ram_peak_mb | controller_ram_avg_mb | controller_ram_peak_mb | nodes_expanded | planner_set
1 | 1 | 1.0 | -0.12 | -0.71 | 0.71 | 0.8000390379291255 | -0.0725462659176109 | 0.2055 | 0.1281 | 9.546020984649658 | 0.2207 | 0.8345 | SUCCEEDED | True | 0 |  | 7 | 0.7333 | 1.0814 | 1.0946 | 11.8 | 14.8 | 0.0 | 0.0 | 23.11 | 23.11 | 23.45 | 23.68 |  | dstar_apf
1 | 2 | 1.25 | -1.04 | -0.71 | 0.71 | 1.0962175760052553 | -0.8790499431287776 | 0.2226 | 0.1753 | 11.099377393722534 | 0.2621 | 1.1025 | SUCCEEDED | True | 0 |  | 9 | 0.8109 | 1.096 | 1.1317 | 12.54 | 16.5 | 0.0 | 0.0 | 23.32 | 23.56 | 23.9 | 23.98 |  | dstar_apf
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
