Joshluk3328j/FYP/benchmark_results/Dynamic data/dynamic_benchmark_results/nav_benchmark_dstar_apf_20260905_235105.csv

trial_num | target_num | given_x | given_y | given_oz | given_ow | final_x | final_y | position_error_m | initial_plan_time_s | total_time_s | planned_path_length_m | actual_path_length_m | status | navigation_interrupted | recovery_events | recovery_success | replanning_events | replanning_frequency_hz | mean_replan_interval_s | worst_replan_interval_s | planner_cpu_avg_% | planner_cpu_peak_% | controller_cpu_avg_% | controller_cpu_peak_% | planner_ram_avg_mb | planner_ram_peak_mb | controller_ram_avg_mb | controller_ram_peak_mb | nodes_expanded | planner_set
2 | 1 | 1.0 | -0.12 | -0.71 | 0.71 | 0.8049356159270478 | -0.025874303296261652 | 0.2166 | 0.1274 | 10.421818971633911 | 0.2207 | 0.8358 | SUCCEEDED | True | 0 |  | 8 | 0.7676 | 1.0863 | 1.1171 | 12.9 | 20.5 | 11.12 | 55.6 | 22.92 | 22.93 | 23.54 | 23.79 |  | dstar_apf
2 | 2 | 1.25 | -1.04 | -0.71 | 0.71 | 1.1057462964716642 | -0.8417265698362623 | 0.2452 | 0.1638 | 11.720338582992554 | 0.2621 | 1.098 | SUCCEEDED | True | 0 |  | 10 | 0.8532 | 1.1114 | 1.2222 | 18.6 | 29.7 | 29.74 | 85.2 | 23.31 | 23.38 | 23.8 | 23.84 |  | dstar_apf
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
