Joshluk3328j/FYP/benchmark_results/Dynamic data/dynamic_benchmark_results/nav_benchmark_dstar_apf_20260910_163845.csv

trial_num | target_num | given_x | given_y | given_oz | given_ow | final_x | final_y | position_error_m | initial_plan_time_s | total_time_s | planned_path_length_m | actual_path_length_m | status | navigation_interrupted | recovery_events | recovery_success | replanning_events | replanning_frequency_hz | mean_replan_interval_s | worst_replan_interval_s | planner_cpu_avg_% | planner_cpu_peak_% | controller_cpu_avg_% | controller_cpu_peak_% | planner_ram_avg_mb | planner_ram_peak_mb | controller_ram_avg_mb | controller_ram_peak_mb | nodes_expanded | planner_set
3 | 1 | 1.0 | -0.12 | -0.71 | 0.71 | 0.8134284487309166 | -0.03242111535561208 | 0.2061 | 0.0883 | 8.882082223892212 | 0.1914 | 0.8489 | SUCCEEDED | True | 0 |  | 8 | 0.9007 | 1.0633 | 1.0787 | 13.37 | 14.9 | 0.0 | 0.0 | 22.73 | 22.73 | 23.29 | 23.42 |  | dstar_apf
3 | 2 | 1.25 | -1.04 | -0.71 | 0.71 | 1.191502358402188 | -0.8064182732708381 | 0.2408 | 0.1965 | 9.32733702659607 | 0.2707 | 0.9246 | SUCCEEDED | True | 3 | True | 7 | 0.7505 | 1.2947 | 2.3226 | 14.43 | 18.6 | 0.0 | 0.0 | 22.84 | 22.87 | 23.51 | 23.71 |  | dstar_apf
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
