Joshluk3328j/FYP/benchmark_results/Dynamic data/dynamic_benchmark_results/nav_benchmark_dstar_apf_20260910_165028.csv

trial_num | target_num | given_x | given_y | given_oz | given_ow | final_x | final_y | position_error_m | initial_plan_time_s | total_time_s | planned_path_length_m | actual_path_length_m | status | navigation_interrupted | recovery_events | recovery_success | replanning_events | replanning_frequency_hz | mean_replan_interval_s | worst_replan_interval_s | planner_cpu_avg_% | planner_cpu_peak_% | controller_cpu_avg_% | controller_cpu_peak_% | planner_ram_avg_mb | planner_ram_peak_mb | controller_ram_avg_mb | controller_ram_peak_mb | nodes_expanded | planner_set
4 | 1 | 1.0 | -0.12 | -0.71 | 0.71 | 0.8200030463776656 | -0.0710585522641933 | 0.1865 | 0.13 | 9.181084394454956 | 0.1707 | 0.8566 | SUCCEEDED | True | 0 |  | 7 | 0.7624 | 1.0733 | 1.1024 | 12.42 | 16.8 | 0.0 | 0.0 | 22.39 | 22.39 | 23.05 | 23.21 |  | dstar_apf
4 | 2 | 1.25 | -1.04 | -0.71 | 0.71 | 1.1643095194835524 | -0.8182580243105806 | 0.2377 | 0.1512 | 9.763071537017822 | 0.3414 | 1.0154 | SUCCEEDED | True | 3 | True | 7 | 0.717 | 1.3166 | 2.4055 | 13.62 | 17.4 | 0.0 | 0.0 | 22.61 | 22.77 | 23.24 | 23.25 |  | dstar_apf
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
