Joshluk3328j/FYP/benchmark_results/Dynamic data/dynamic_benchmark_results/nav_benchmark_dstar_apf_20260915_144808.csv

trial_num | target_num | given_x | given_y | given_oz | given_ow | final_x | final_y | position_error_m | initial_plan_time_s | total_time_s | planned_path_length_m | actual_path_length_m | status | navigation_interrupted | recovery_events | recovery_success | replanning_events | replanning_frequency_hz | mean_replan_interval_s | worst_replan_interval_s | planner_cpu_avg_% | planner_cpu_peak_% | controller_cpu_avg_% | controller_cpu_peak_% | planner_ram_avg_mb | planner_ram_peak_mb | controller_ram_avg_mb | controller_ram_peak_mb | nodes_expanded | planner_set
6 | 1 | 1.0 | -0.12 | -0.71 | 0.71 | 0.8312319795283394 | -0.04726634813642037 | 0.1838 | 0.0973 | 9.39242959022522 | 0.2207 | 0.87 | SUCCEEDED | True | 0 |  | 7 | 0.7453 | 1.0752 | 1.0991 | 13.75 | 16.1 | 0.0 | 0.0 | 22.99 | 22.99 | 23.23 | 23.36 |  | dstar_apf
6 | 2 | 1.25 | -1.04 | -0.71 | 0.71 | 1.1924889830388268 | -0.7971834233753848 | 0.2495 | 0.1944 | 8.74863886833191 | 0.3414 | 0.9742 | SUCCEEDED | True | 0 |  | 7 | 0.8001 | 1.0832 | 1.0925 | 14.15 | 19.5 | 0.0 | 0.0 | 23.22 | 23.38 | 22.79 | 22.82 |  | dstar_apf
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
