Joshluk3328j/FYP/benchmark_results/Dynamic data/dynamic_benchmark_results/nav_benchmark_dstar_apf_20260915_150435.csv

trial_num | target_num | given_x | given_y | given_oz | given_ow | final_x | final_y | position_error_m | initial_plan_time_s | total_time_s | planned_path_length_m | actual_path_length_m | status | navigation_interrupted | recovery_events | recovery_success | replanning_events | replanning_frequency_hz | mean_replan_interval_s | worst_replan_interval_s | planner_cpu_avg_% | planner_cpu_peak_% | controller_cpu_avg_% | controller_cpu_peak_% | planner_ram_avg_mb | planner_ram_peak_mb | controller_ram_avg_mb | controller_ram_peak_mb | nodes_expanded | planner_set
5 | 1 | 1.0 | -0.12 | -0.71 | 0.71 | 0.8248850767476327 | -0.08276512320663401 | 0.179 | 0.1018 | 9.270769119262695 | 0.2207 | 0.867 | SUCCEEDED | True | 0 |  | 8 | 0.8629 | 1.0726 | 1.1037 | 15.0 | 18.1 | 16.57 | 66.3 | 22.37 | 22.37 | 22.64 | 22.64 |  | dstar_apf
5 | 2 | 1.25 | -1.04 | -0.71 | 0.71 | 1.158574632903741 | -0.803904022655434 | 0.2532 | 0.1556 | 8.458322048187256 | 0.3621 | 0.948 | SUCCEEDED | True | 0 |  | 7 | 0.8276 | 1.0667 | 1.1046 | 14.03 | 16.1 | 0.0 | 0.0 | 22.59 | 22.66 | 23.29 | 23.38 |  | dstar_apf
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
