Joshluk3328j/FYP/benchmark_results/Dynamic data/Dynamic map_with Obstacles.png

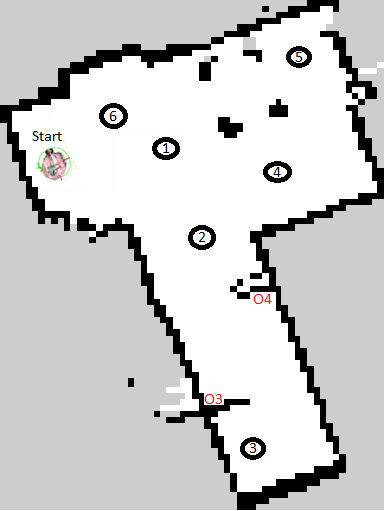
benchmark_results/Dynamic data/Dynamic map_with Obstacles.png
