Joshluk3328j/FYP/benchmark_results/Dynamic data/figures/fig1_success_rate.png

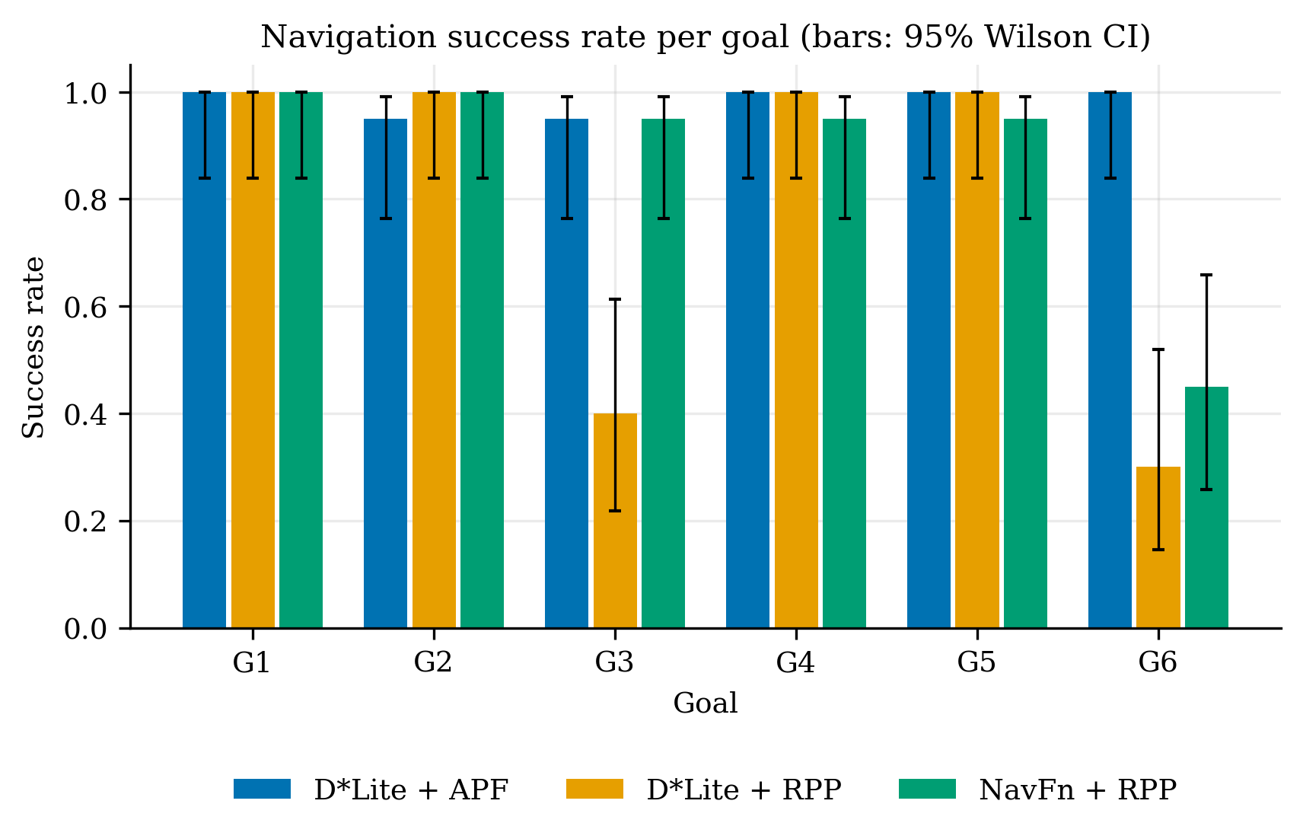
benchmark_results/Dynamic data/figures/fig1_success_rate.png
