Joshluk3328j/FYP/benchmark_results/Dynamic data/figures/fig3_recovery_replanning.png

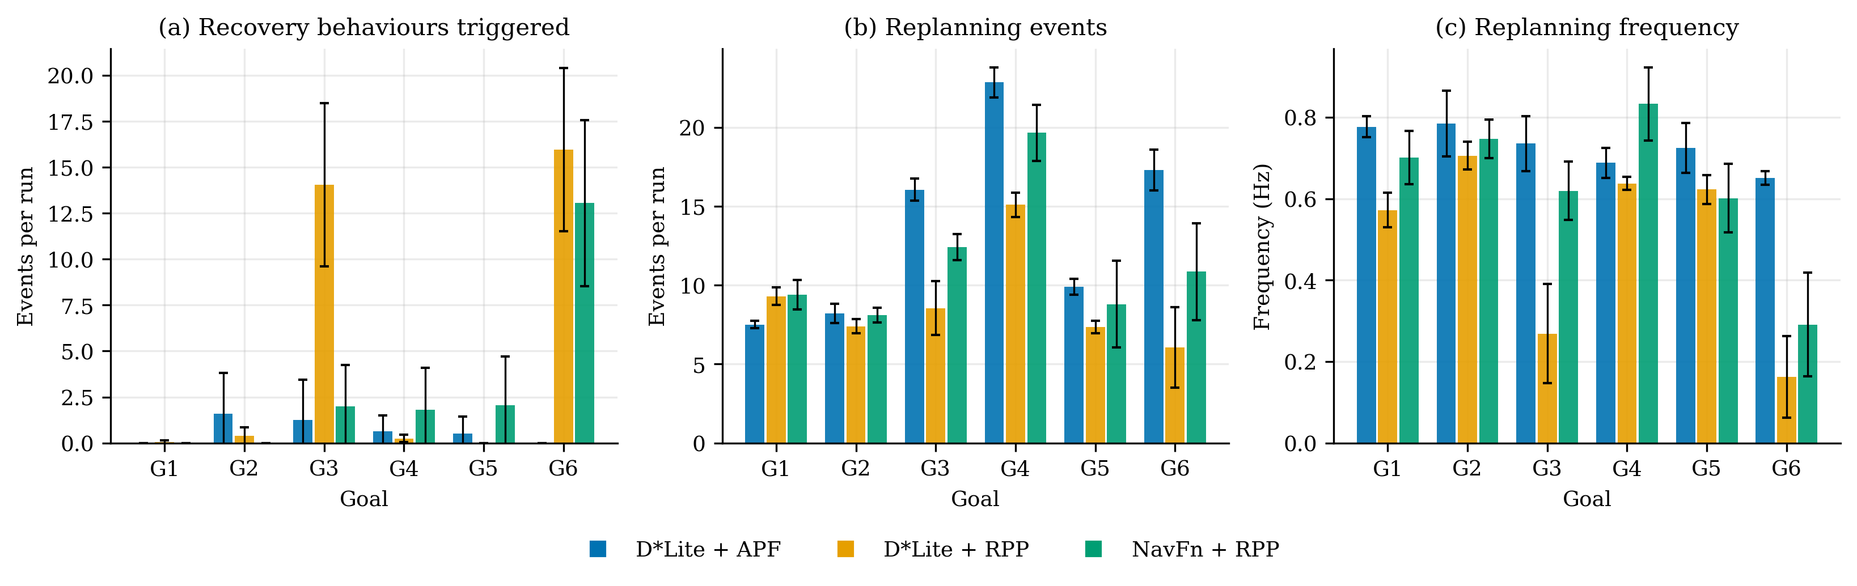
benchmark_results/Dynamic data/figures/fig3_recovery_replanning.png
