Joshluk3328j/FYP/benchmark_results/Static_Bench_mark/algorithm_test_map.png

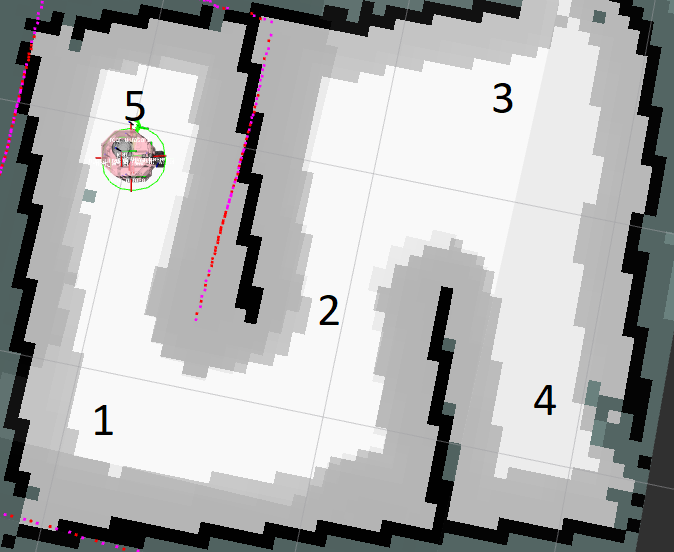
benchmark_results/Static_Bench_mark/algorithm_test_map.png
