Joshluk3328j/FYP/benchmark_results/Static_Bench_mark/Screenshot from 2026-06-28 00-46-01.png

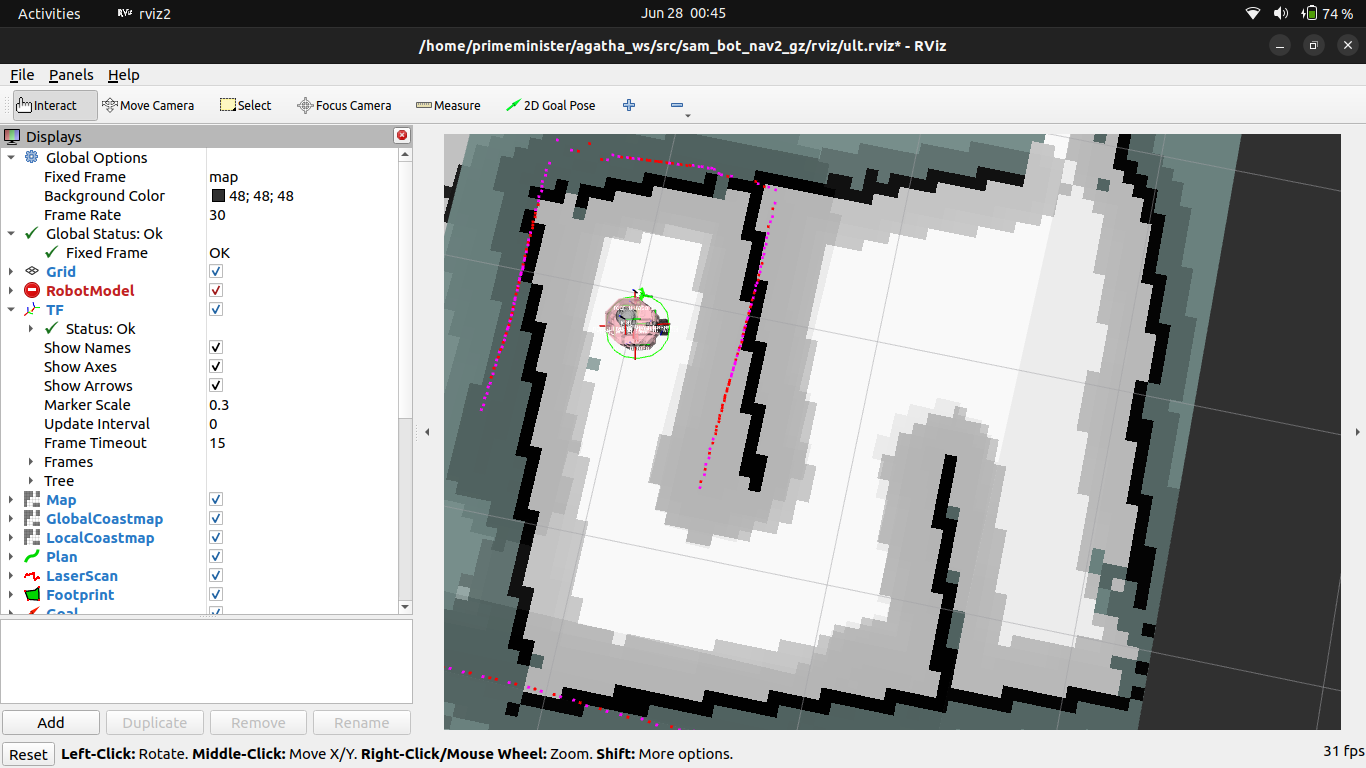
benchmark_results/Static_Bench_mark/Screenshot from 2026-06-28 00-46-01.png
