Joshluk3328j/FYP/AGATHA_CAD_Model/parts/Assem2.pdf

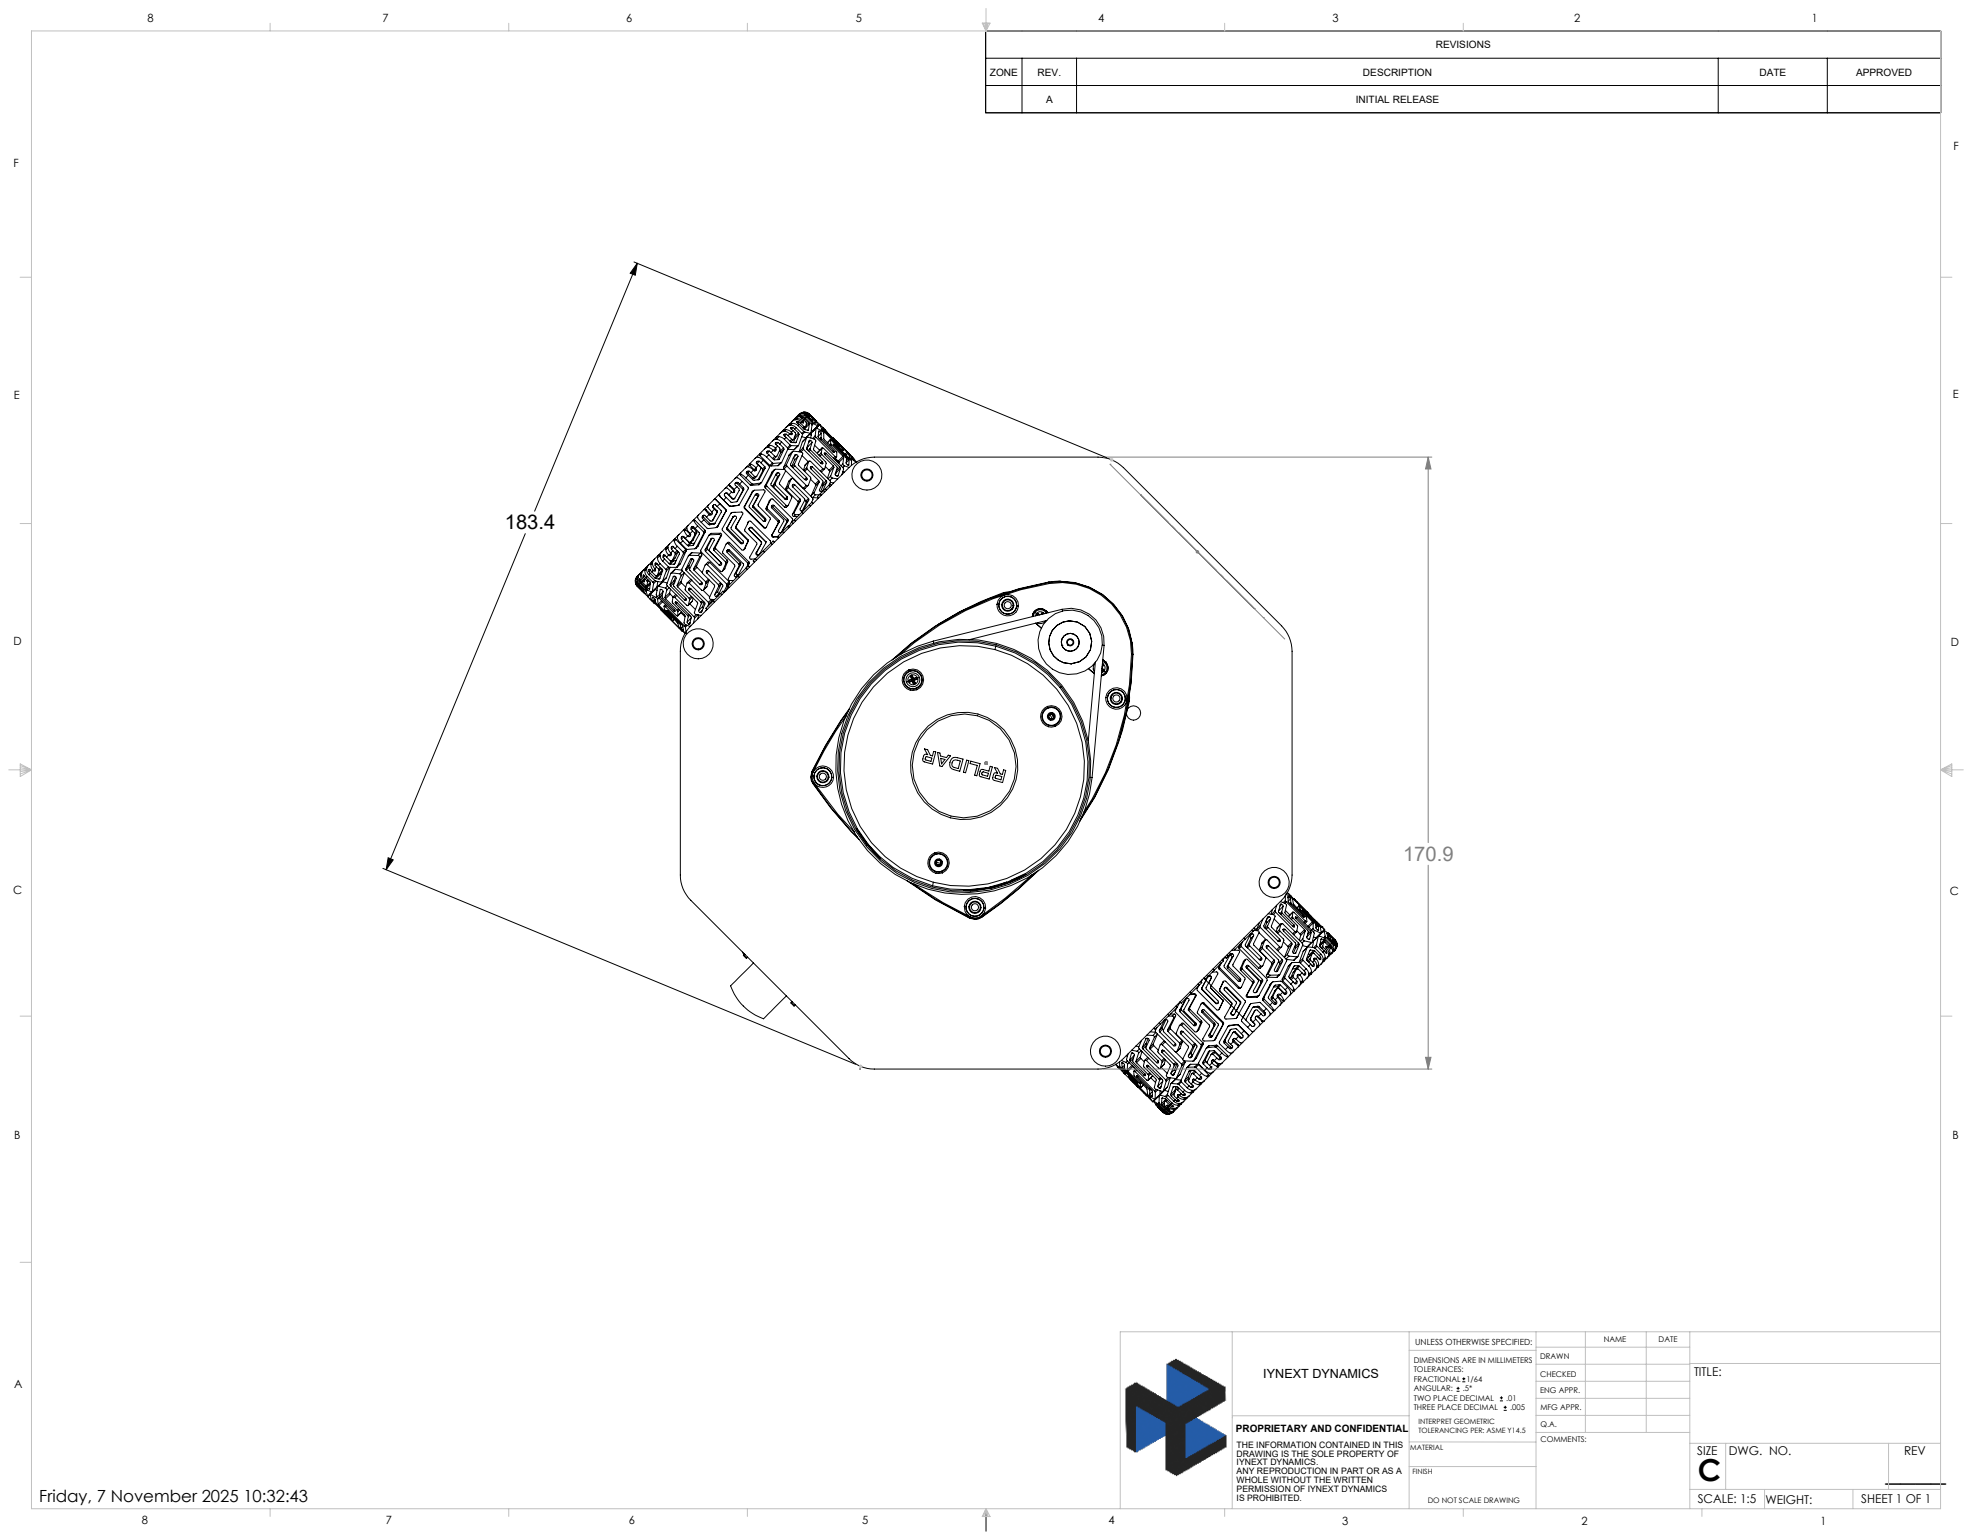
[picture p41: page 1]
SHEET 1 OF 1; SCALE: 1:5 WEIGHT:; DWG. NO.; REV; MFG APPR.; ENG APPR.; IS PROHIBITED.; DO NOT SCALE DRAWING; IYNEXT DYNAMICS; Friday, 7 November 2025 10:32:43

ZONE | REV. | DESCRIPTION | DATE | APPROVED

A | INITIAL RELEASE

UNLESS OTHERWISE SPECIFIED:
DIMENSIONS ARE IN MILLIMETERS
TOLERANCES:
FRACTIONAL 1/64
ANGULAR: .5*
TWO PLACE DECIMAL .01
THREE PLACE DECIMAL .005
INTERPRET GEOMETRIC
TOLERANCING PER: ASME Y14.5
MATERIAL

PROPRIETARY AND CONFIDENTIAL
THE INFORMATION CONTAINED IN THIS
DRAWING IS THE SOLE PROPERTY OF
IYNEXT DYNAMICS.
ANY REPRODUCTION IN PART OR AS A
WHOLE WITHOUT THE WRITTEN
PERMISSION OF IYNEXT DYNAMICS
