Joshluk3328j/FYP/agatha/frames_2026-04-04_16.55.55.pdf

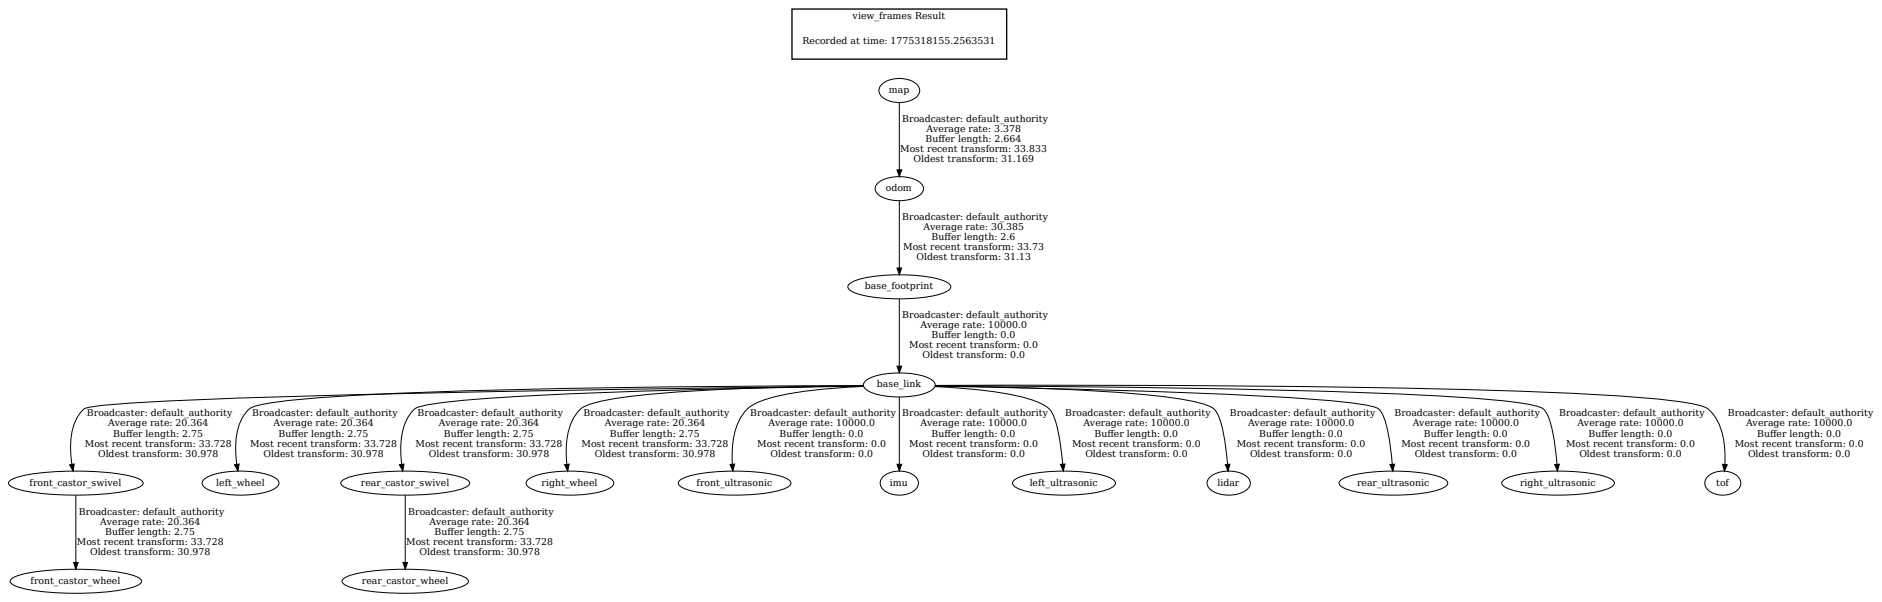
[picture p42: page 1]
view_frames Result; map; odom; base_footprint; base_link; front_castor_swivel; left_wheel; rear_castor_swivel; right_wheel; front_ultrasonic; imu; left_ultrasonic; lidar; rear_ultrasonic; right_ultrasonic; tof; front_castor_wheel; rear_castor_wheel

Recorded at time: 1775318155.2563531

Broadcaster: default_authority
Average rate: 3.378
Buffer length: 2.664
Most recent transform: 33.833
Oldest transform: 31.169

Average rate: 30.385
Buffer length: 2.6
Most recent transform: 33.73
Oldest transform: 31.13

Average rate: 10000.0
Buffer length: 0.0
Most recent transform: 0.0
Oldest transform: 0.0

Average rate: 20.364
Buffer length: 2.75
Most recent transform: 33.728
Oldest transform: 30.978
