Joshluk3328j/FYP/AGATHA_CAD_Model/drawing/exploaded_view.pdf

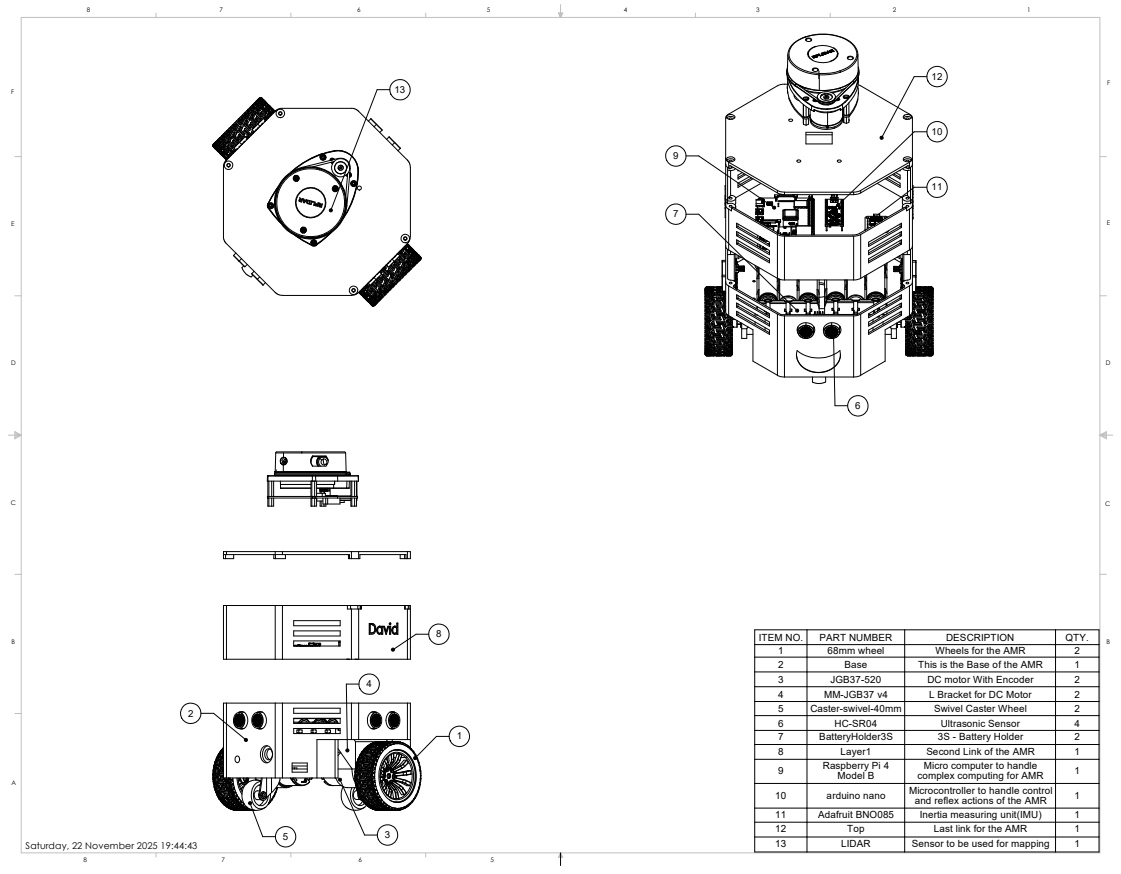
[picture p43: page 1]
Saturday, 22 November 2025 19:44:43; ITEM NO.; PART NUMBER; DESCRIPTION; QTY.; 68mm wheel; Wheels for the AMR; Base; This is the Base of the AMR; JGB37-520; DC motor With Encoder; MM-JGB37 v4; L Bracket for DC Motor; Caster-swivel-40mm; Swivel Caster Wheel; Ultrasonic Sensor; BatteryHolder3S; 3S - Battery Holder; Layer1; Second Link of the AMR; Raspberry Pi 4 Model B; complex computing for AMR; arduino nano; Microcontroller to handle control; and reflex actions of the AMR; Adafruit BNO085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

Micro computer to handle

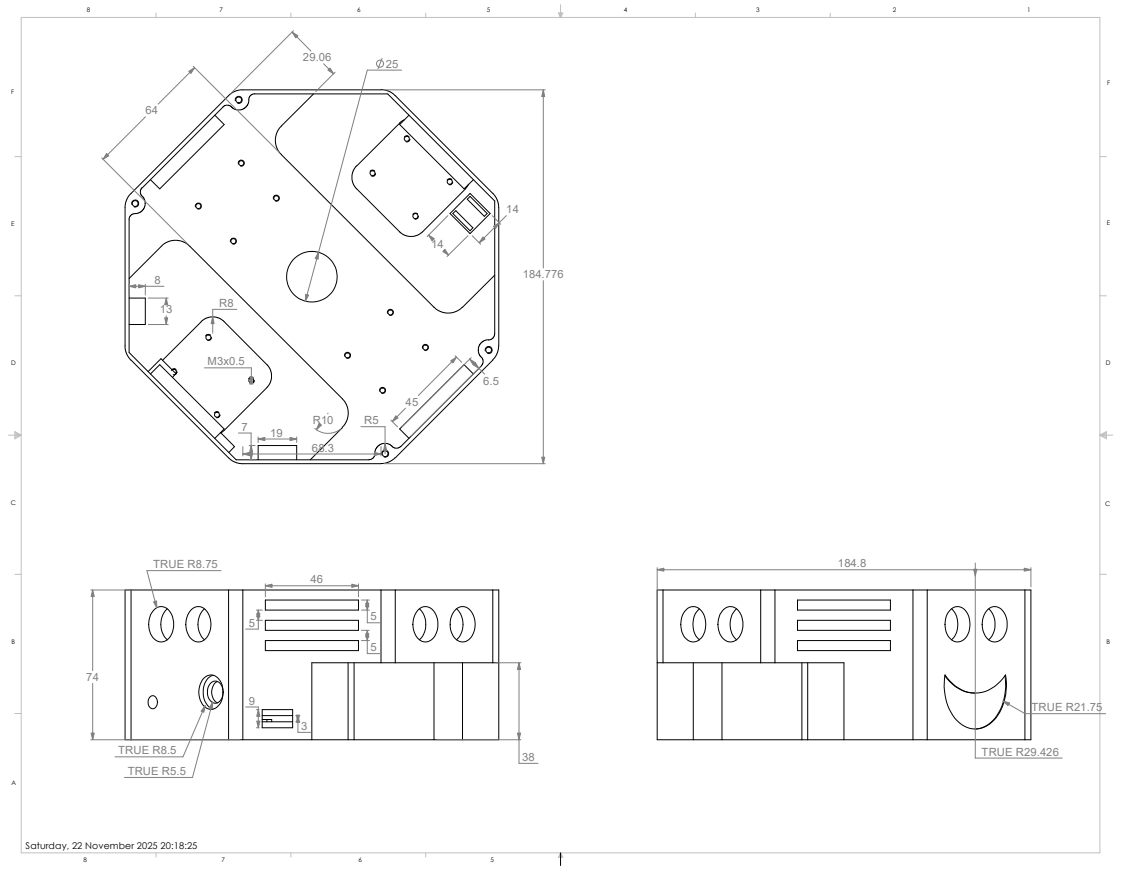
[picture p44: page 2]
Saturday, 22 November 2025 20:18:25; TRUE R8.75; TRUE R8.5; TRUE R5.5; TRUE R29.426; TRUE R21.75

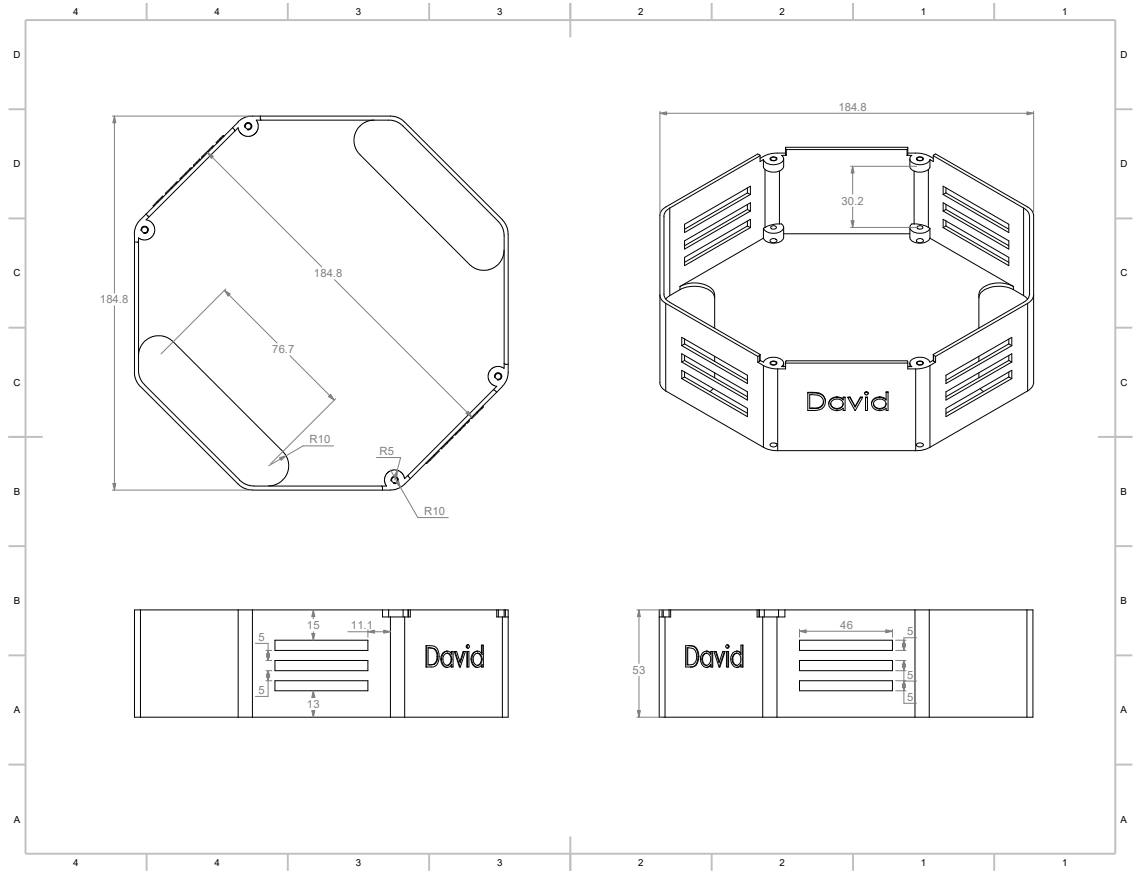
[picture p45: page 3]

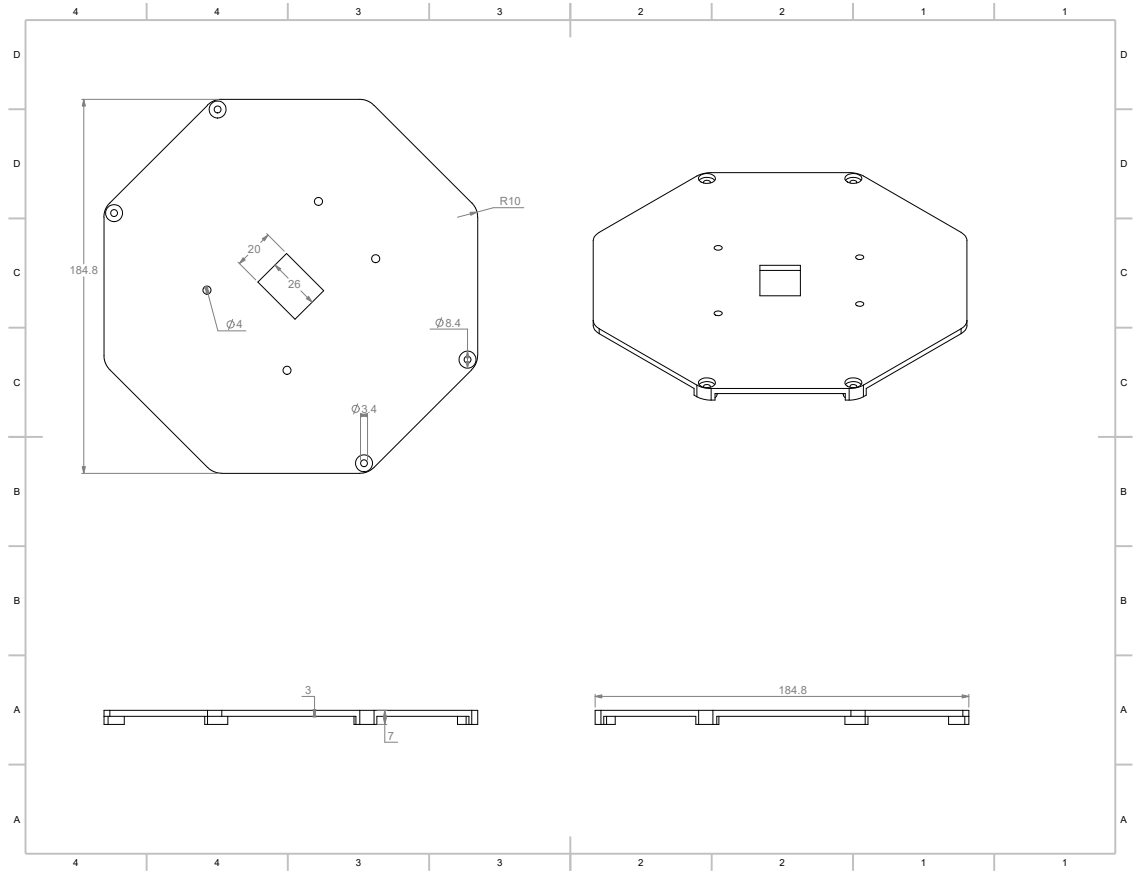
[picture p46: page 4]
