Joshluk3328j/FYP/benchmark_results/Dynamic data/figures/fig2_accuracy_time_distance.pdf

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

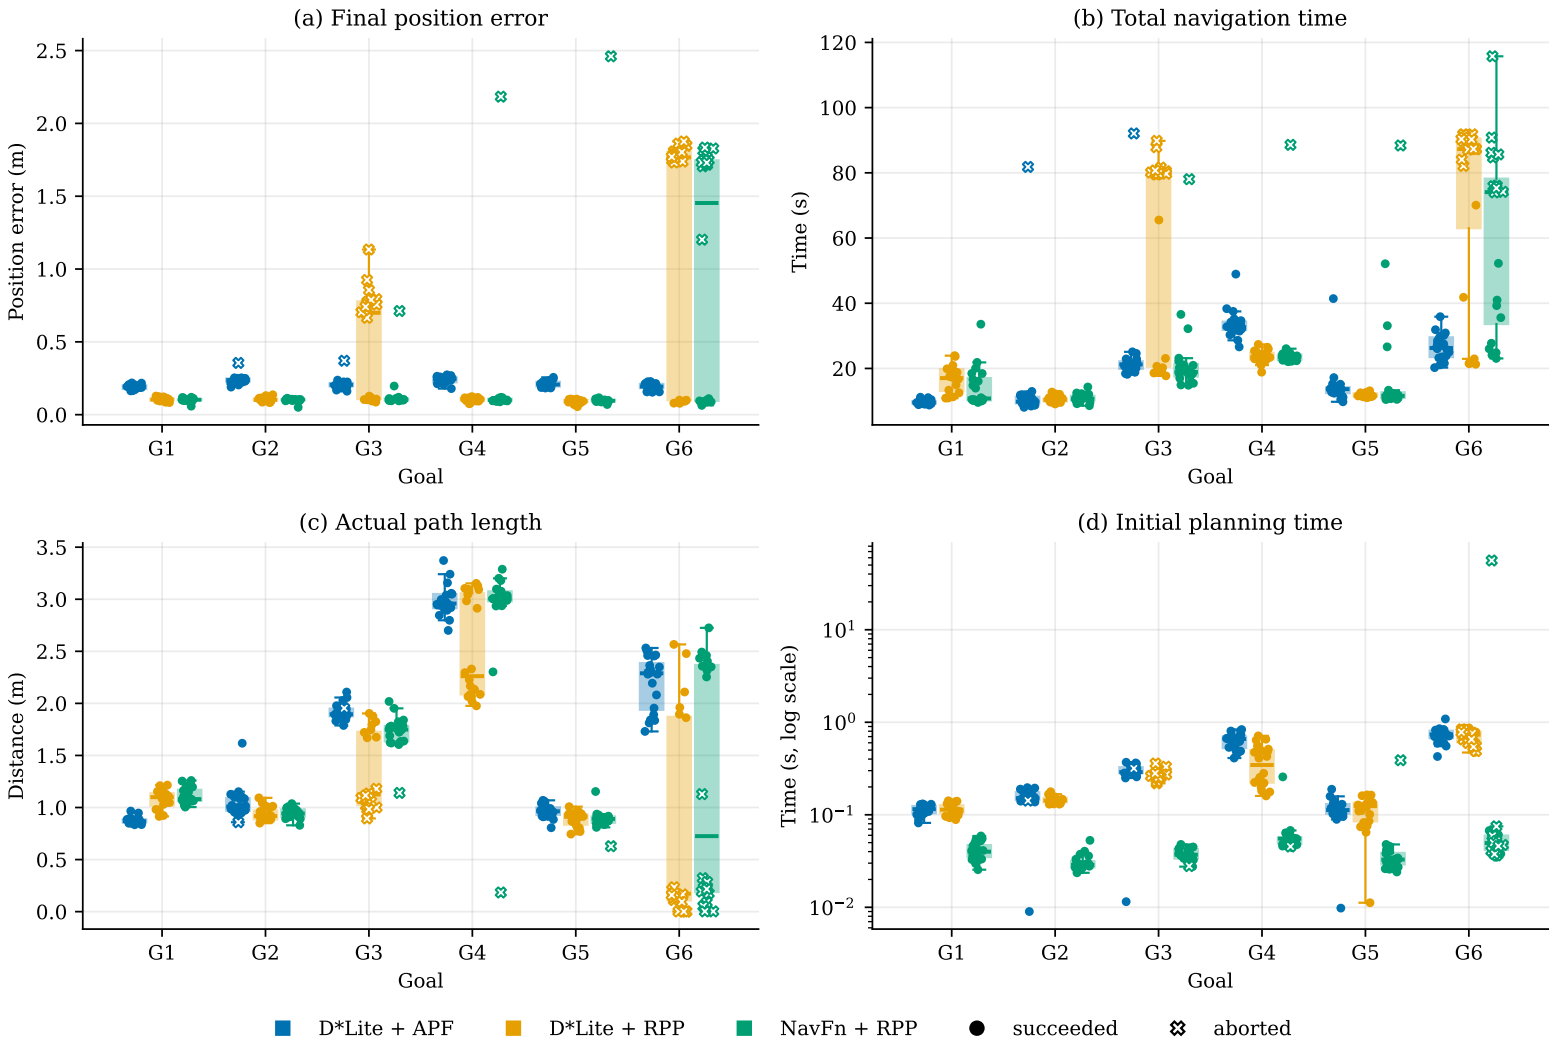
[picture p47: page 1]
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
