Joshluk3328j/FYP/benchmark_results/Dynamic data/figures/fig4_overall_and_compute.pdf

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

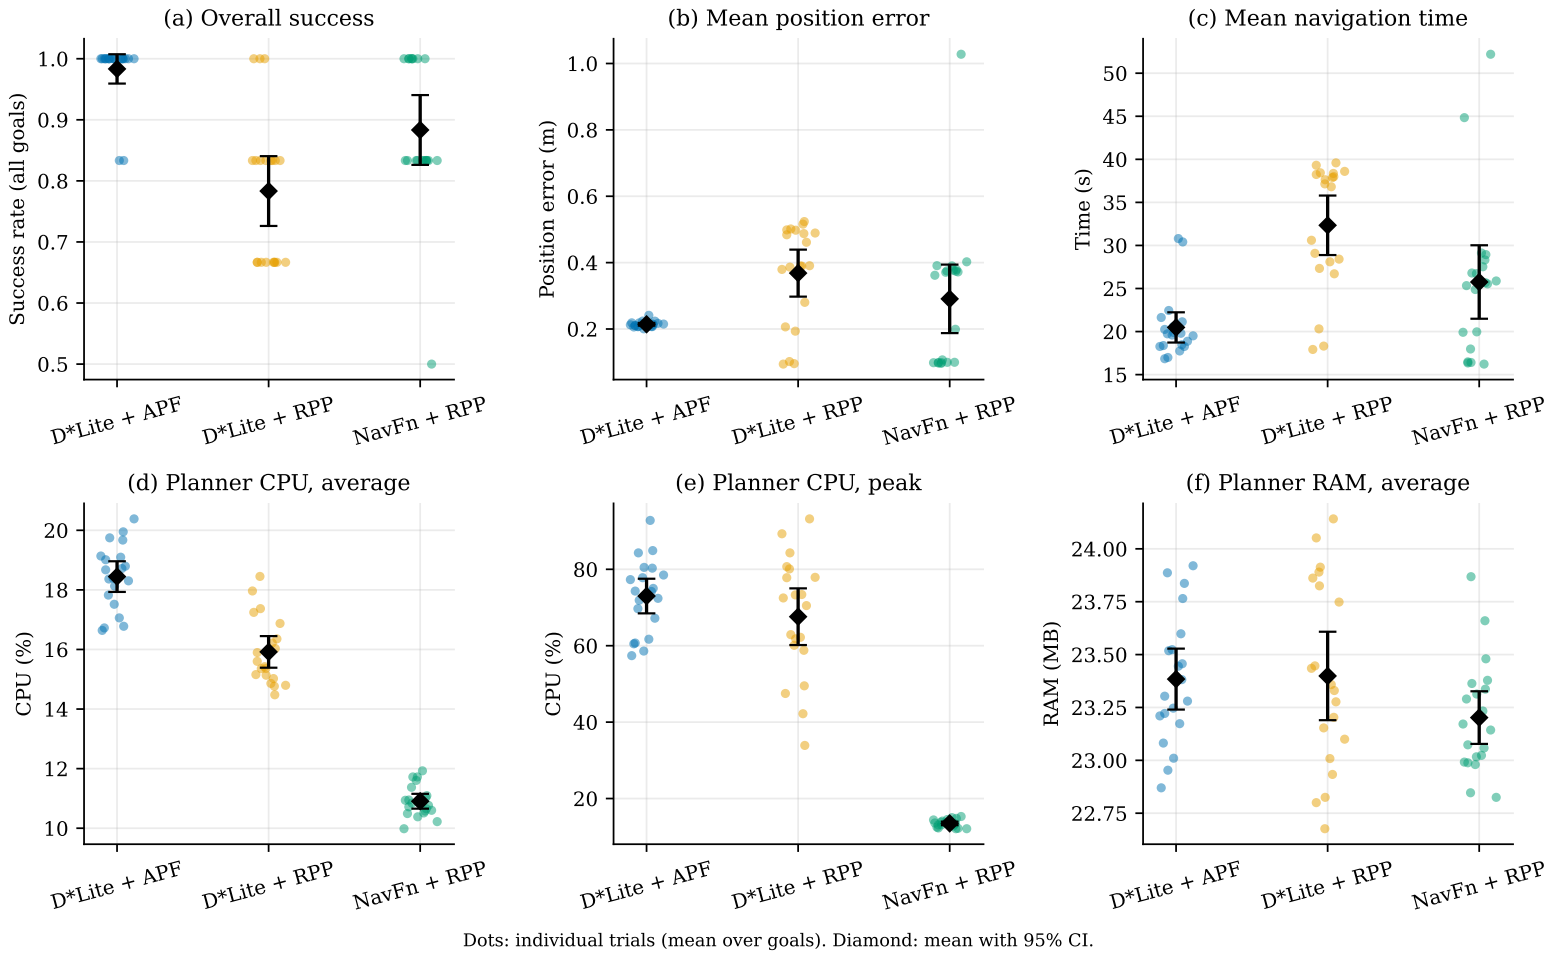
[picture p48: page 1]
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
