Joshluk3328j/FYP/agatha/frames_2026-09-03_10.08.32.pdf

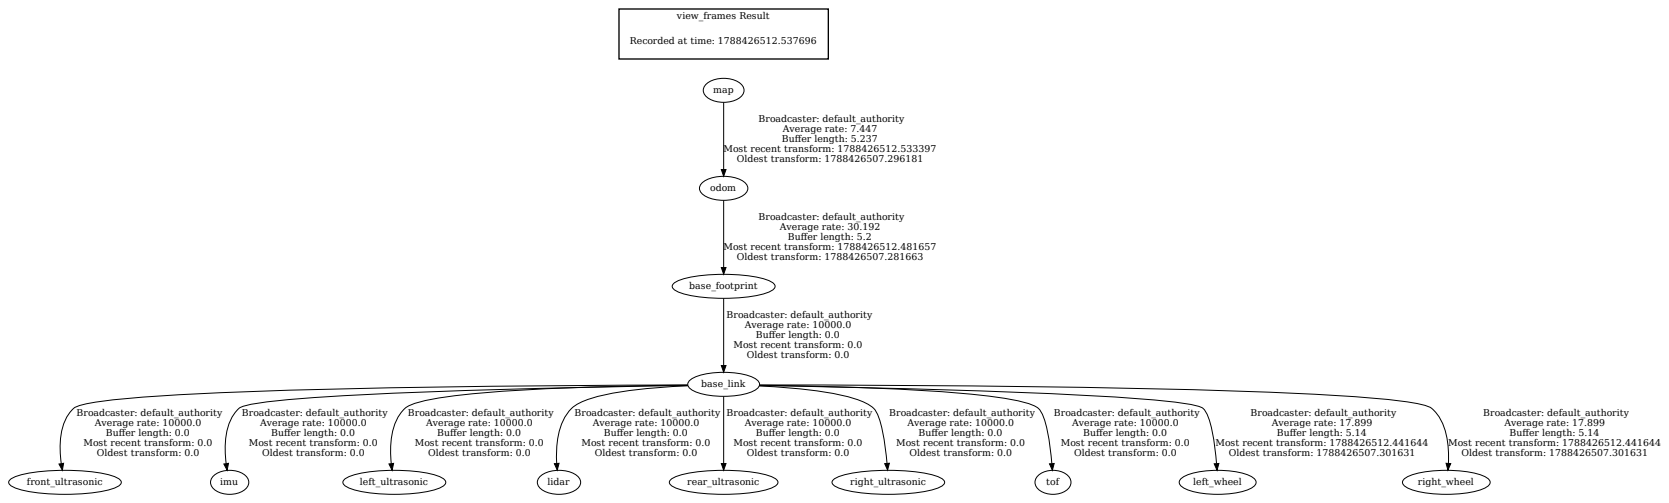
[picture p49: page 1]
view_frames Result; map; odom; Broadcaster: default_authority Average rate: 7.447 Buffer length: 5.237; base_footprint; Broadcaster: default_authority Average rate: 30.192 Buffer length: 5.2; base_link; front_ultrasonic; imu; left_ultrasonic; lidar; rear_ultrasonic; right_ultrasonic; tof; left_wheel; Broadcaster: default_authority Average rate: 17.899 Buffer length: 5.14; right_wheel

Recorded at time: 1788426512.537696

Most recent transform: 1788426512.533397
Oldest transform: 1788426507.296181

Most recent transform: 1788426512.481657
Oldest transform: 1788426507.281663

Broadcaster: default_authority
Average rate: 10000.0
Buffer length: 0.0
Most recent transform: 0.0
Oldest transform: 0.0

Most recent transform: 1788426512.441644
Oldest transform: 1788426507.301631
