Joshluk3328j/FYP/agatha/install/sam_bot_nav2_gz/share/sam_bot_nav2_gz/config/planners/dstar_apf.yaml

amcl:
  ros__parameters:
    use_sim_time: False
    alpha1: 0.2
    alpha2: 0.2
    alpha3: 0.2
    alpha4: 0.2
    alpha5: 0.2
    base_frame_id: "base_footprint"
    beam_skip_distance: 0.5
    beam_skip_error_threshold: 0.9
    beam_skip_threshold: 0.3
    do_beamskip: false
    global_frame_id: "map"
    lambda_short: 0.1
    laser_likelihood_max_dist: 2.0
    laser_max_range: 100.0
    laser_min_range: -1.0
    laser_model_type: "likelihood_field"
    max_beams: 60
    max_particles: 2000
    min_particles: 500
    odom_frame_id: "odom"
    pf_err: 0.05
    pf_z: 0.99
    recovery_alpha_fast: 0.0
    recovery_alpha_slow: 0.0
    resample_interval: 1
    robot_model_type: "nav2_amcl::DifferentialMotionModel"
    save_pose_rate: 0.5
    sigma_hit: 0.2
    tf_broadcast: true
    transform_tolerance: 2.0
    update_min_a: 0.2
    update_min_d: 0.25
    z_hit: 0.5
    z_max: 0.05
    z_rand: 0.5
    z_short: 0.05
    scan_topic: scan

amcl_map_client:
  ros__parameters:
    use_sim_time: False

amcl_rclcpp_node:
  ros__parameters:
    use_sim_time: False

bt_navigator:
  ros__parameters:
    default_bt_xml_filename: "navigate_to_pose_w_replanning_and_recovery.xml"
    use_sim_time: False
    global_frame: map
    robot_base_frame: base_footprint
    odom_topic: /odom
    bt_loop_duration: 10
    default_server_timeout: 20
    enable_groot_monitoring: True
    groot_zmq_publisher_port: 1666
    groot_zmq_server_port: 1667
    plugin_lib_names:
    - nav2_compute_path_to_pose_action_bt_node
    - nav2_compute_path_through_poses_action_bt_node
    - nav2_follow_path_action_bt_node
    - nav2_back_up_action_bt_node
    - nav2_spin_action_bt_node
    - nav2_wait_action_bt_node
    - nav2_clear_costmap_service_bt_node
    - nav2_is_stuck_condition_bt_node
    - nav2_goal_reached_condition_bt_node
    - nav2_goal_updated_condition_bt_node
    - nav2_initial_pose_received_condition_bt_node
    - nav2_reinitialize_global_localization_service_bt_node
    - nav2_rate_controller_bt_node
    - nav2_distance_controller_bt_node
    - nav2_speed_controller_bt_node
    - nav2_truncate_path_action_bt_node
    - nav2_goal_updater_node_bt_node
    - nav2_recovery_node_bt_node
    - nav2_pipeline_sequence_bt_node
    - nav2_round_robin_node_bt_node
    - nav2_transform_available_condition_bt_node
    - nav2_time_expired_condition_bt_node
    - nav2_distance_traveled_condition_bt_node
    - nav2_single_trigger_bt_node
    - nav2_is_battery_low_condition_bt_node
    - nav2_navigate_through_poses_action_bt_node
    - nav2_navigate_to_pose_action_bt_node
    - nav2_remove_passed_goals_action_bt_node
    - nav2_planner_selector_bt_node
    - nav2_controller_selector_bt_node
    - nav2_goal_checker_selector_bt_node

bt_navigator_rclcpp_node:
  ros__parameters:
    use_sim_time: False

controller_server:
  ros__parameters:
    use_sim_time: False
    controller_frequency: 8.0 #10.0
    min_x_velocity_threshold: 0.001
    min_y_velocity_threshold: 0.001 #changed from 0.50.5
    min_theta_velocity_threshold: 0.001
    failure_tolerance: 1.0 #0.3
    progress_checker_plugin: "progress_checker"
    goal_checker_plugins: ["general_goal_checker"]
    controller_plugins: ["FollowPath"]

    cmd_vel_topic: "/diff_drive_base_controller/cmd_vel_unstamped"

    progress_checker:
      plugin: "nav2_controller::SimpleProgressChecker"
      required_movement_radius: 0.1
      movement_time_allowance: 20.0             # ← Increased
    
    general_goal_checker:
      stateful: True
      plugin: "nav2_controller::SimpleGoalChecker"
      xy_goal_tolerance: 0.25 # 0.12          # ← tightened from 0.25
      yaw_goal_tolerance: 0.25 # 0.15         # ← tightened from 0.25
    FollowPath:
      plugin: "apf_controller/APFController"
      k_att: 45.0          # was 70 — too aggressive, overpowers repulsion in tight spaces
      k_rep: 0.012 #0.025         # was 0.008 — needs to be stronger to actually push away from walls
      influence_radius: 0.55  # was 0.52 — sense walls earlier, gentler avoidance
      max_linear_vel: 0.26     # was 0.28 — slower on real hardware = more reaction time
      max_angular_vel: 1.5     # was 1.8 — slight reduction for smoother turns
      lookahead_dist: 0.35     # was 0.45 — shorter lookahead in tight spaces is safer
      lethal_cost_threshold: 220   # was 240 — react to walls even earlier
    # FollowPath:
    #   plugin: "apf_controller/APFController"
    #   k_att: 70.0          # was 50 — a bit lower for less aggressive pulling
    #   k_rep: 0.008         # was 0.015 — reduce so repulsion doesn't dominate
    #   influence_radius: 0.52   # increased a little for earlier, gentler avoidance
    #   max_linear_vel: 0.28
    #   max_angular_vel: 1.8     # allow slightly faster turning but we'll smooth it
    #   lookahead_dist: 0.45
    #   lethal_cost_threshold: 240   # start reacting earlier than 253
    # FollowPath:
    #   plugin: "nav2_regulated_pure_pursuit_controller::RegulatedPurePursuitController"   # ← change to this
    #   debug_trajectory_details: True
    #   min_vel_x: 0.0
    #   min_vel_y: 0.0
    #   max_vel_x: 0.26
    #   max_vel_y: 0.0
    #   max_vel_theta: 1.0
    #   min_speed_xy: 0.0
    #   max_speed_xy: 0.26
    #   min_speed_theta: 0.0
    #   # Add high threshold velocity for turtlebot 3 issue.
    #   # https://github.com/ROBOTIS-GIT/turtlebot3_simulations/issues/75
    #   acc_lim_x: 2.5
    #   acc_lim_y: 0.0
    #   acc_lim_theta: 3.2
    #   decel_lim_x: -2.5
    #   decel_lim_y: 0.0
    #   decel_lim_theta: -3.2
    #   vx_samples: 20
    #   vy_samples: 5
    #   vtheta_samples: 20
    #   sim_time: 1.7
    #   linear_granularity: 0.05
    #   angular_granularity: 0.025
    #   transform_tolerance: 0.2
    #   xy_goal_tolerance: 0.25
    #   trans_stopped_velocity: 0.05 # 0.25
    #   short_circuit_trajectory_evaluation: True
    #   stateful: True
    #   critics: ["RotateToGoal", "Oscillation", "BaseObstacle", "GoalAlign", "PathAlign", "PathDist", "GoalDist"]
    #   BaseObstacle.scale: 0.02
    #   PathAlign.scale: 32.0
    #   PathAlign.forward_point_distance: 0.1
    #   GoalAlign.scale: 24.0
    #   GoalAlign.forward_point_distance: 0.1
    #   PathDist.scale: 32.0
    #   GoalDist.scale: 24.0
    #   RotateToGoal.scale: 32.0
    #   RotateToGoal.slowing_factor: 5.0
    #   RotateToGoal.lookahead_time: -1.0


controller_server_rclcpp_node:
  ros__parameters:
    use_sim_time: False

local_costmap:
  local_costmap:
    ros__parameters:
      update_frequency: 10.0
      publish_frequency: 5.0
      global_frame: odom
      robot_base_frame: base_footprint
      use_sim_time: False
      rolling_window: true
      width: 3
      height: 3
      resolution: 0.05
      robot_radius: 0.12
      # voxel_layer handles the LiDAR (above 10 cm)
      # range_sensor_layer handles the 4 HC-SR04 ultrasonics (0–9 cm floor zone)
      plugins: ["voxel_layer", "inflation_layer"]

      voxel_layer:
        plugin: "nav2_costmap_2d::VoxelLayer"
        enabled: True
        publish_voxel_map: True
        origin_z: 0.0
        z_resolution: 0.05
        z_voxels: 16
        max_obstacle_height: 2.0
        mark_threshold: 0
        # Ultrasonics removed — handled by range_sensor_layer below
        observation_sources: scan
        scan:
          topic: /scan
          data_type: "LaserScan"
          sensor_frame: "lidar"
          marking: True
          clearing: True
          min_obstacle_height: 0.10
          max_obstacle_height: 2.0
          raytrace_min_range: 0.0
          raytrace_max_range: 3.0
          obstacle_min_range: 0.0
          obstacle_max_range: 2.5
          observation_persistence: 1.0  # was 0.2

      # ── Range sensor layer — HC-SR04 ultrasonics ──────────────────────────
      # Handles the floor-level blind zone the LiDAR cannot see (0–9 cm height).
      # Each sensor's cone FOV is modelled correctly by this plugin; no fake
      # LaserScan conversion needed.
      # range_sensor_layer:
      #   plugin: "nav2_costmap_2d::RangeSensorLayer"
      #   enabled: True
      #   topics: ["/front_ultrasonic", "/rear_ultrasonic", "/left_ultrasonic", "/right_ultrasonic"]
        
      #   phi: 0.2618                  # ~15° FOV — good
      #   inflate_cone: 0.05           # smaller buffer is usually better
      #   no_readings_timeout: 4.0
        
      #   input_sensor_type: "VARIABLE"   # Correct since your Range msgs have varying range values
        
      #   # Important ones you're missing / have wrong:
      #   clear_on_max_reading: true     # ← ADD THIS (very important!)
      #   mark_threshold: 0.65 #0.75           # probability to mark occupied
      #   clear_threshold: 0.25          # probability to clear / mark free
      #   observation_persistence: 3 #4
      #   # Optional but helpful:
      #   combination_method: 1          # 0=Overwrite, 1=Max (usually better)

      inflation_layer:
        plugin: "nav2_costmap_2d::InflationLayer"
        cost_scaling_factor: 1.0 #3.0
        inflation_radius: 0.19 #0.12 #0.18   # reduced from 0.35 — robot is only 12cm radius

      static_layer:
        map_subscribe_transient_local: True
        always_send_full_costmap: True

  local_costmap_client:
    ros__parameters:
      use_sim_time: False
  local_costmap_rclcpp_node:
    ros__parameters:
      use_sim_time: False

global_costmap:
  global_costmap:
    ros__parameters:
      update_frequency: 1.0
      publish_frequency: 1.0
      global_frame: map
      robot_base_frame: base_footprint
      use_sim_time: False
      robot_radius: 0.12
      resolution: 0.05
      track_unknown_space: true
      plugins: ["static_layer", "obstacle_layer", "inflation_layer"]
      obstacle_layer:
        plugin: "nav2_costmap_2d::ObstacleLayer"
        enabled: True
        observation_sources: scan
        scan:
          topic: /scan
          max_obstacle_height: 2.0
          clearing: True
          marking: True
          data_type: "LaserScan"
          raytrace_max_range: 3.0
          raytrace_min_range: 0.0
          obstacle_max_range: 2.5
          obstacle_min_range: 0.0

      # range_sensor_layer:
      #   plugin: "nav2_costmap_2d::RangeSensorLayer"
      #   enabled: True
      #   topics: ["/front_ultrasonic", "/rear_ultrasonic", "/left_ultrasonic", "/right_ultrasonic"]
      #   phi: 0.2618
      #   inflate_cone: 0.05
      #   no_readings_timeout: 1.5 #2.0
      #   input_sensor_type: "VARIABLE"
      #   clear_on_max_reading: true
      #   mark_threshold: 0.65 #0.75
      #   observation_persistence: 3 #4
      #   clear_threshold: 0.25
      #   combination_method: 1
      static_layer:
        plugin: "nav2_costmap_2d::StaticLayer"
        map_subscribe_transient_local: True
      inflation_layer:
        plugin: "nav2_costmap_2d::InflationLayer"
        cost_scaling_factor: 1.0 #3.0
        inflation_radius: 0.19 #0.12 #0.18
      always_send_full_costmap: True
  global_costmap_client:
    ros__parameters:
      use_sim_time: False
  global_costmap_rclcpp_node:
    ros__parameters:
      use_sim_time: False

map_server:
  ros__parameters:
    use_sim_time: False
    yaml_filename: "turtlebot3_world.yaml"

map_saver:
  ros__parameters:
    use_sim_time: False
    save_map_timeout: 5.0
    free_thresh_default: 0.25
    occupied_thresh_default: 0.65
    map_subscribe_transient_local: True

planner_server:
  ros__parameters:
    expected_planner_frequency: 5.0
    use_sim_time: False
    planner_plugins: ["GridBased"]
    GridBased:
      # plugin: "nav2_navfn_planner/NavfnPlanner"
      plugin: "dstar_lite_planner/DStarLitePlanner" 
      allow_unknown: true    # ← add this
      tolerance: 0.5


planner_server_rclcpp_node:
  ros__parameters:
    use_sim_time: False

recoveries_server:
  ros__parameters:
    costmap_topic: local_costmap/costmap_raw
    footprint_topic: local_costmap/published_footprint
    cycle_frequency: 10.0
    recovery_plugins: ["backup", "spin", "wait"]
    spin:
      plugin: "nav2_recoveries/Spin"
    backup:
      plugin: "nav2_recoveries/BackUp"
    wait:
      plugin: "nav2_recoveries/Wait"
    global_frame: odom
    robot_base_frame: base_footprint
    transform_timeout: 0.1
    use_sim_time: False
    simulate_ahead_time: 2.0
    max_rotational_vel: 1.2
    min_rotational_vel: 0.2
    rotational_acc_lim: 3.2

robot_state_publisher:
  ros__parameters:
    use_sim_time: False

waypoint_follower:
  ros__parameters:
    loop_rate: 20
    stop_on_failure: false
    waypoint_task_executor_plugin: "wait_at_waypoint"
    wait_at_waypoint:
      plugin: "nav2_waypoint_follower::WaitAtWaypoint"
      enabled: True
      waypoint_pause_duration: 200
