Joshluk3328j/FYP/(commit log)

2026-02-10 cad model and urdf files
    [Adafruit BNO085 STEMMA QT.step, Assem2.csv, Assem2.urdf, Base.SLDPRT, Base.STL, BatteryHolder3S.STEP, Body1_caster.SLDPRT, Body2_caster.SLDPRT]
2026-04-24 minor updates
    [Adafruit BNO085 STEMMA QT.step, Assem2.csv, Assem2.urdf, Base.SLDPRT, Base.STL, BatteryHolder3S.STEP, Body1_caster.SLDPRT, Body2_caster.SLDPRT]
2026-04-25 A few updates
    [Adafruit BNO085 STEMMA QT.step, Assem2.csv, Assem2.urdf, Base.SLDPRT, Base.STL, BatteryHolder3S.STEP, Body1_caster.SLDPRT, Body2_caster.SLDPRT]
