Joshluk3328j/FYP/(notices)

Notices in the files:
AGATHA_CAD_Model/parts/GY-530 VL53L0X ToF.obj:
3ds Max Wavefront OBJ Exporter v0.99 - (c)2007 guruware
